COAST-Lab/c3po/Hardware/README.MD

# Bill of Materials
Please note: Prices are listed in USD and are subject to change based on market value and availability.

# Upper Body
Part | Function | Cost | URL
| :---------------- | :------ | :---- | :---- |
Boron LTE-M (NorAm) with EtherSIM (BRN404X) | IoT Development Board with cellular capability | $48.95 | https://store.particle.io/products/boron-lte-cat-m1-noram-with-ethersim-4th-gen
Adalogger FeatherWing - RTC + SD Add-On for All Feather Boards | Real-time I2C clock + SD port; internal datalogging | $8.95 | https://www.adafruit.com/product/2922
CR1220 Coin Battery | Battery for Adalogger FeatherWing | $0.95 |  https://www.adafruit.com/product/380
Samsung EVO Plus 64GB 100/MB/s Micro SDXC Memory Card with Adapter | Store measurements locally | $13.73 | https://www.amazon.com/gp/product/B07349L1WS/ref=sw_img_1?smid=A1VBIOM77ZTQRM&psc=1
Voltaic 5W 5V Solar System | Use solar energy to power sensor electronics | $99.00 |  https://voltaicsystems.com/5-watt-5-volt-35wh-solar-system/
Standard Breadboard | UART to I2C protocol; connecting electronics without soldering (for setup process only) | $2.90 | https://www.digikey.com/en/products/detail/dfrobot/FIT0096/7597069
Jumper cables / prototyping wires | UART to I2C protocol; connecting electronics (for setup process only) | $1.95 | https://www.digikey.com/en/products/detail/adafruit-industries-llc/1954/6827087
Polycase SK-14 | Housing electronics of upper body | $21.77 | https://www.polycase.com/sk-14
CG-32 Cable glands (2), gray, 0.170–0.450in | Threading solar & 4-wire cable into Polycase | $2.86 per; $5.72 total | https://www.polycase.com/cg3-cable-glands#CG-32
3D printed chassis | Holding Boron, Adalogger, & cellular antenna inside Polycase | Custom print | 
Thread-forming mounting boss screws | Fastening 3D printed chassis to Polycase | $8.50 per 100 pack | https://www.polycase.com/screws-022-100

Fastener options for chassis:
Part | Function | Cost | URL
| :---------------- | :------ | :---- | :---- |
18-8 Stainless Steel Socket Head Screw M2.5x0.45mm Thread, 18mm long | Mounting Boron + FeatherWing to chassis | $15.75 per 50 pack | https://www.mcmaster.com/91292A028/
18-8 Stainless Steel Hex Nut M2.5x0.45mm Thread, 2mm height | Mounting Boron & Adalogger to chassis | $6.45 per 100 pack | https://www.mcmaster.com/91828A113/
M2.5x6 or M2.5x5+6mm screws + hex nuts of choice| | | 
M2.5+6.5mm standoffs of choice | | | 

# Lower Body
Part | Function | Cost | URL
| :---------------- | :------ | :---- | :---- |
AtlasScientific K0.1 EZO-Conductivity Kit | Measures water conductivity with range from 0.07µs to 50,000µs | $219.99 | https://atlas-scientific.com/kits/conductivity-k-0-1-kit/
AtlasScientific SMA PT-1000 Temperature Kit | Measures water temperature | $43.99 | https://atlas-scientific.com/kits/sma-temperature-kit/
(N/A) Tentacle T3 Shield | Carrier board for EZO circuits; discontinued | $101.99 | https://www.whiteboxes.ch/docs/tentacle/t3/#/
Altas i3 Interlink | Carrier board for EZO circuits (replaced Tentacle T3 Shield) | $54.99 | https://atlas-scientific.com/electrical-isolation/i3-interlink/
4-wire waterproof cable | Transmit measurements from sensor to EZO board + Boron | $15 ($5/m) | https://bluerobotics.com/store/cables-connectors/pur-subsea-cable/
Female 3.5x1.1mm - MicroUSB Adapter | Connects solar panel to Boron | $3.00 | https://voltaicsystems.com/A101
3" Sch 40 PVC pipe | Encloses sensors; attaches to signpost | $10.96 ($5.98/ft, sold as 24in) | https://www.homedepot.com/p/IPEX-3-in-x-24-in-Rigid-PVC-Schedule-40-Pipe-2203/205706641
3D printed pipe cap, top | Pipe cap, with attached chassis to hold i3 Interlink with EZO circuits inside PVC pipe | Custom print | 
Cable gland (1), 0.105–0.315in | Waterproof cable entry for 4-wire cable | $2.23/unit | https://www.polycase.com/cg3-cable-glands#CG-31
3D printed pipe cap, bottom | For bottom of PVC pipe, where probes are fastened & exit pipe | Custom print |
Loctite Marine Epoxy | Attaching pipe caps to PVC pipe; attaching propes to pipe caps; waterproof sealant | $7.20 | https://www.amazon.com/dp/B00KH62K50?tag=psuni-01-us-340-20&ascsubtag=wtbs_6792893518cb9545d7275495&th=1

Fastener options for chassis:
Part | Function | Cost | URL
| :---------------- | :------ | :---- | :---- |
18-8 Stainless Steel Socket Head Screw M2.5x0.45mm Thread, 10mm long | Mounting i3 Interlink to chassis | $6.54 per 100 pack | https://www.mcmaster.com/91292A014/
18-8 Stainless Steel Hex Nut M2.5x0.45mm Thread, 2mm height | Mounting i3 Interlink to chassis | $6.45 per 100 pack | https://www.mcmaster.com/91828A113/
M2.5x0.45mm screws + hex nuts of choice | | |
M2.5x0.45mm standoffs of choice | | |
