COAST-Lab/c3po/Removable_Housing/ReadMe.md

Objectives:
- Create an upgraded housing that allows easy access to electrical components and sensors
  while maintaining water tight reliability
- Add opening for pressure transducer

Design Improvements:

 **Removable End Caps** 
  - Sensor cap (facing downwards)
  - Top cap (port to brain/power)
  This allows for easy access to internal components without damaging the housing.

 **Exterior Fastening**
- Each cap was designed with a circular overhang with 2 (oppisite side) 1/4 inch holes
- Each hole is used for a 1/4 inch screw to lock-in endcaps
- Screws are fastened on oppisite sides with hex nuts

 **O-Ring Sealing System**  
- The housing uses O-ring grooves to maintain a watertight seal while still allowing repeated
  opening and closing.

 **Pressure Sensor Integration**  
- An additional port has been incorporated to accommodate a pressure sensor, enabling depth
  measurements to be included in the system’s output data.

**Benefits**
- Non-destructive access to electronics and sensors  
- Improved maintenance and replacement capability  (for sensors, interlink, etc..)
- Reusable housing design  
- Expanded data collection through depth sensing

**Notes**
- This design is intended for testing. Fit, sealing performance, and materials 
(sanding requirments and O-ring compression) should be validated before field use.
