COAST-Lab/c3po/Data Analysis/Figures/c3po_time-series_2025-Apr-Oct.png

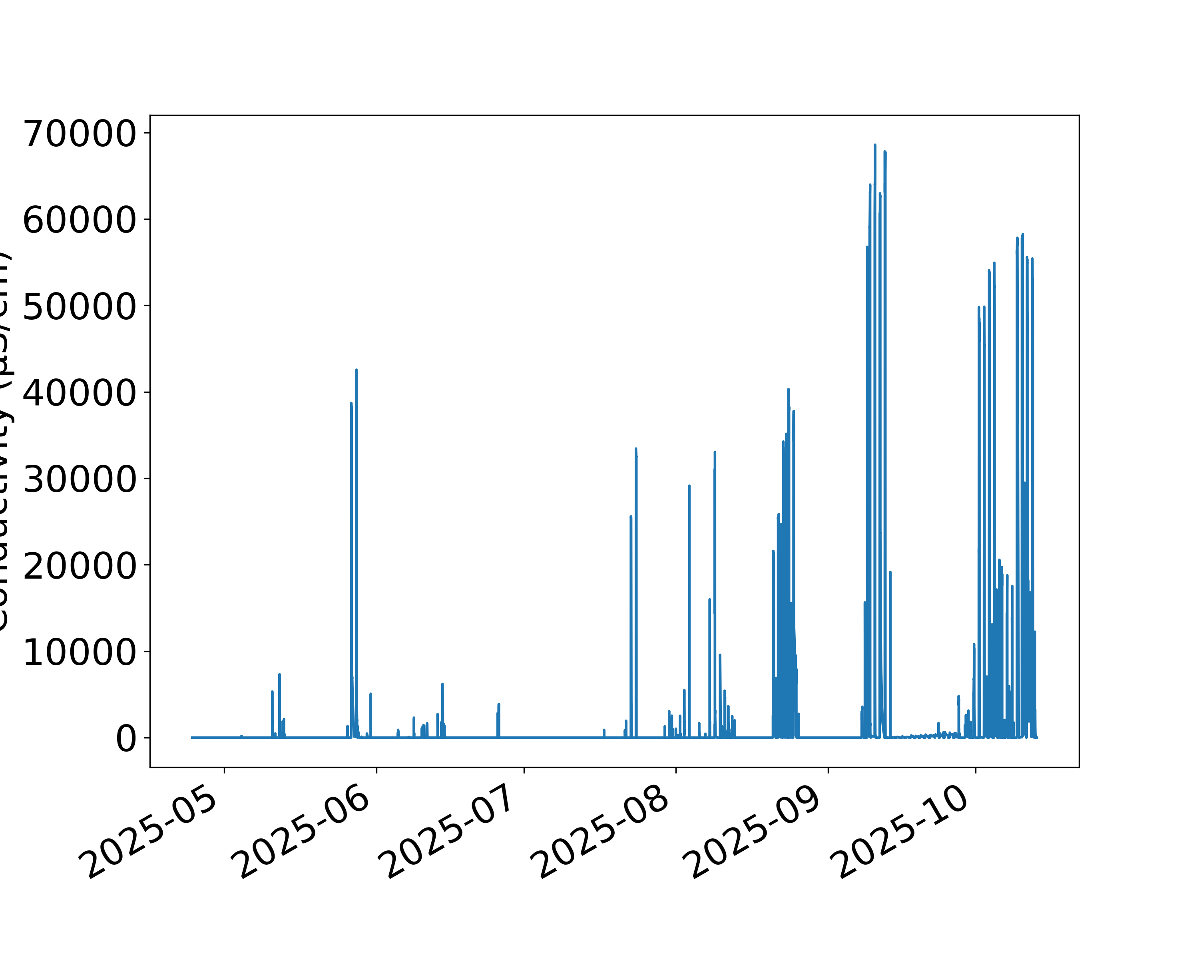
Data Analysis/Figures/c3po_time-series_2025-Apr-Oct.png
