COAST-Lab/c3po/Data Analysis/Figures/C3PO_waterlevel_example.png

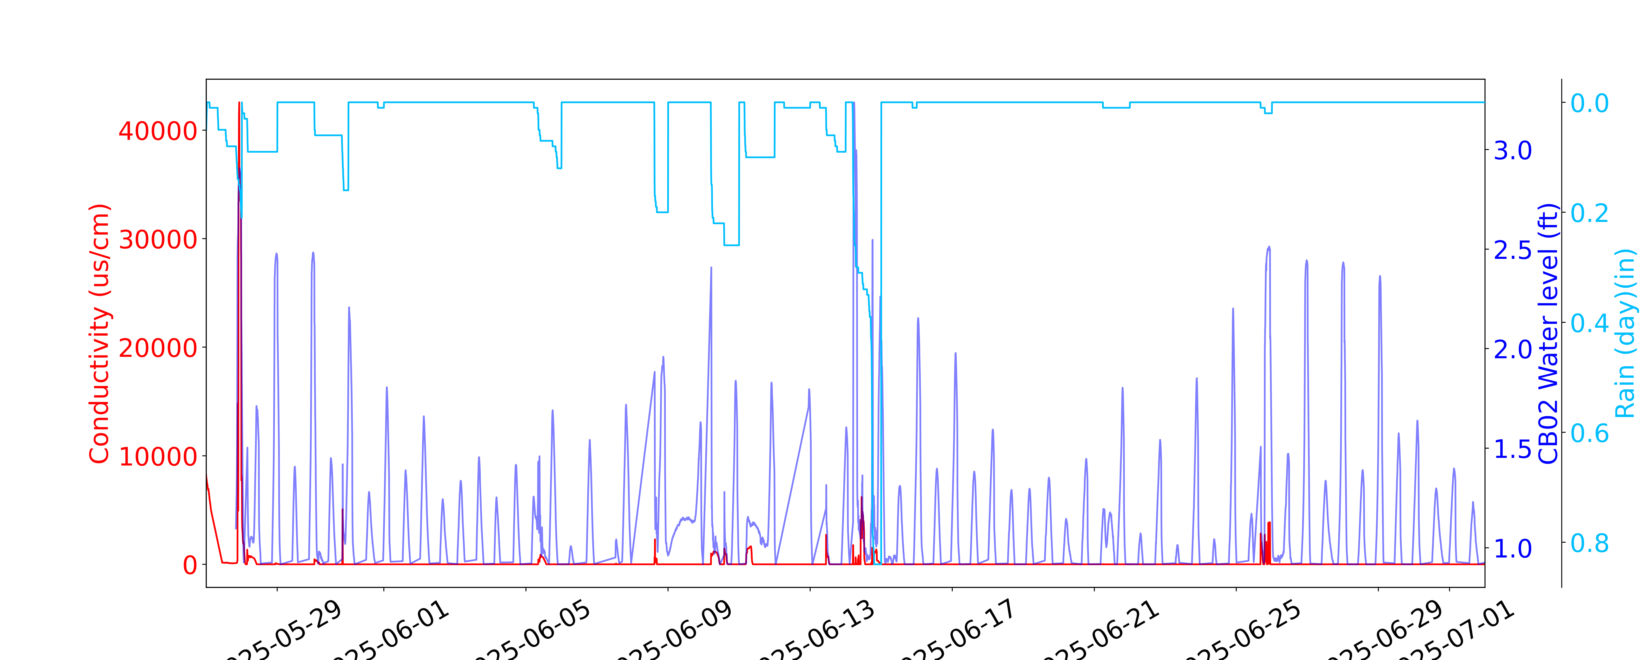
Data Analysis/Figures/C3PO_waterlevel_example.png
