COAST-Lab/c3po/Data Analysis/Figures/C3PO_waterlevel_salinity_lf.png

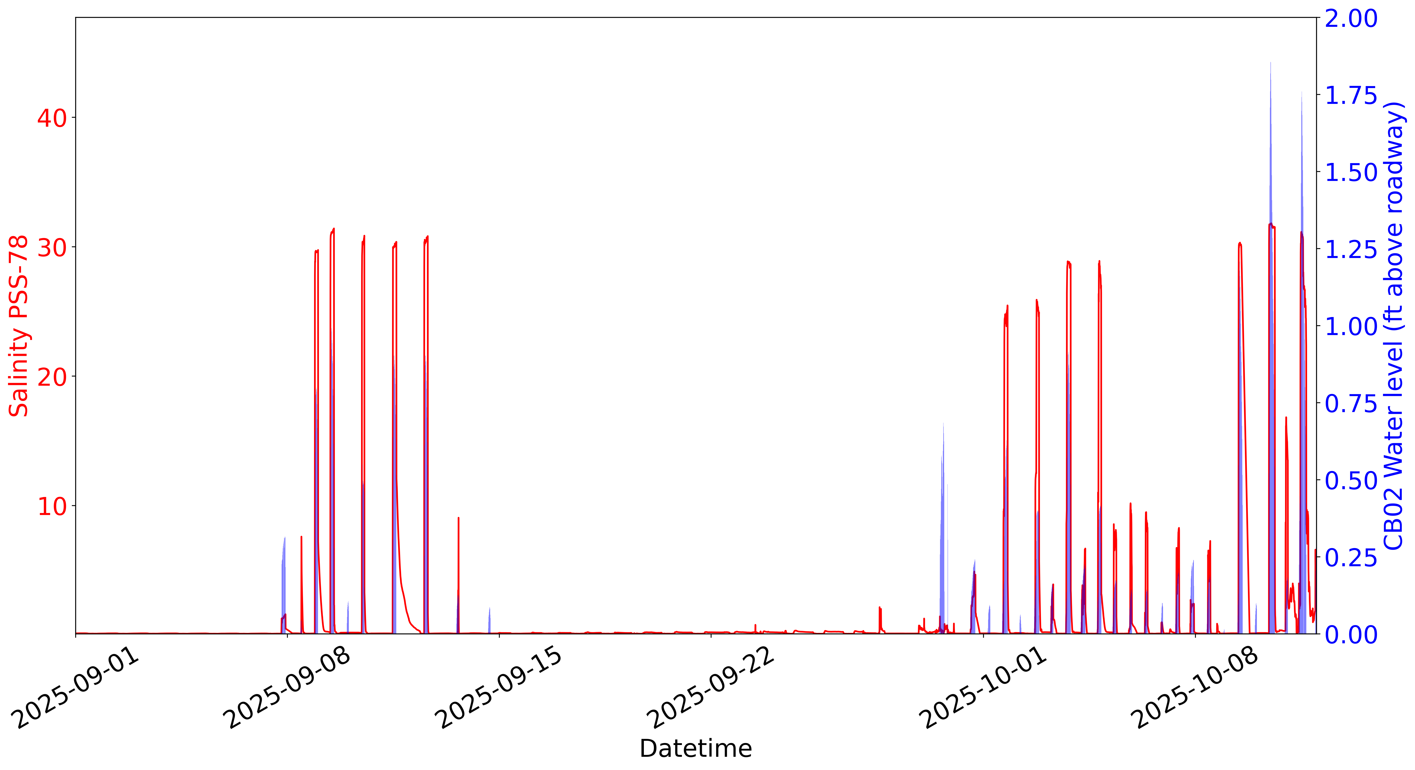
Data Analysis/Figures/C3PO_waterlevel_salinity_lf.png
