COAST-Lab/c3po/Data Analysis/Figures/C3PO_waterlevel_salinity_pjb.png

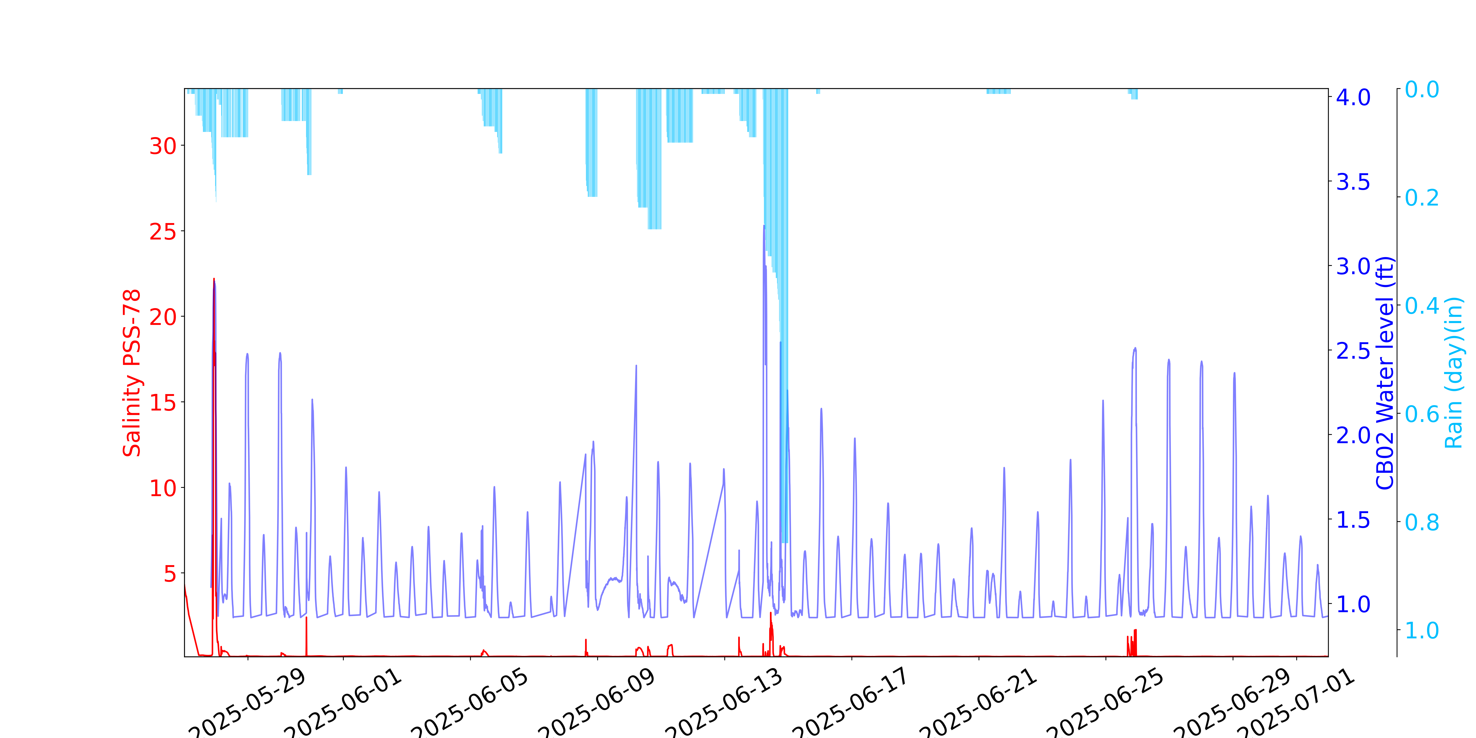
Data Analysis/Figures/C3PO_waterlevel_salinity_pjb.png
