COAST-Lab/c3po/Data Analysis/Figures/C3POExample.png

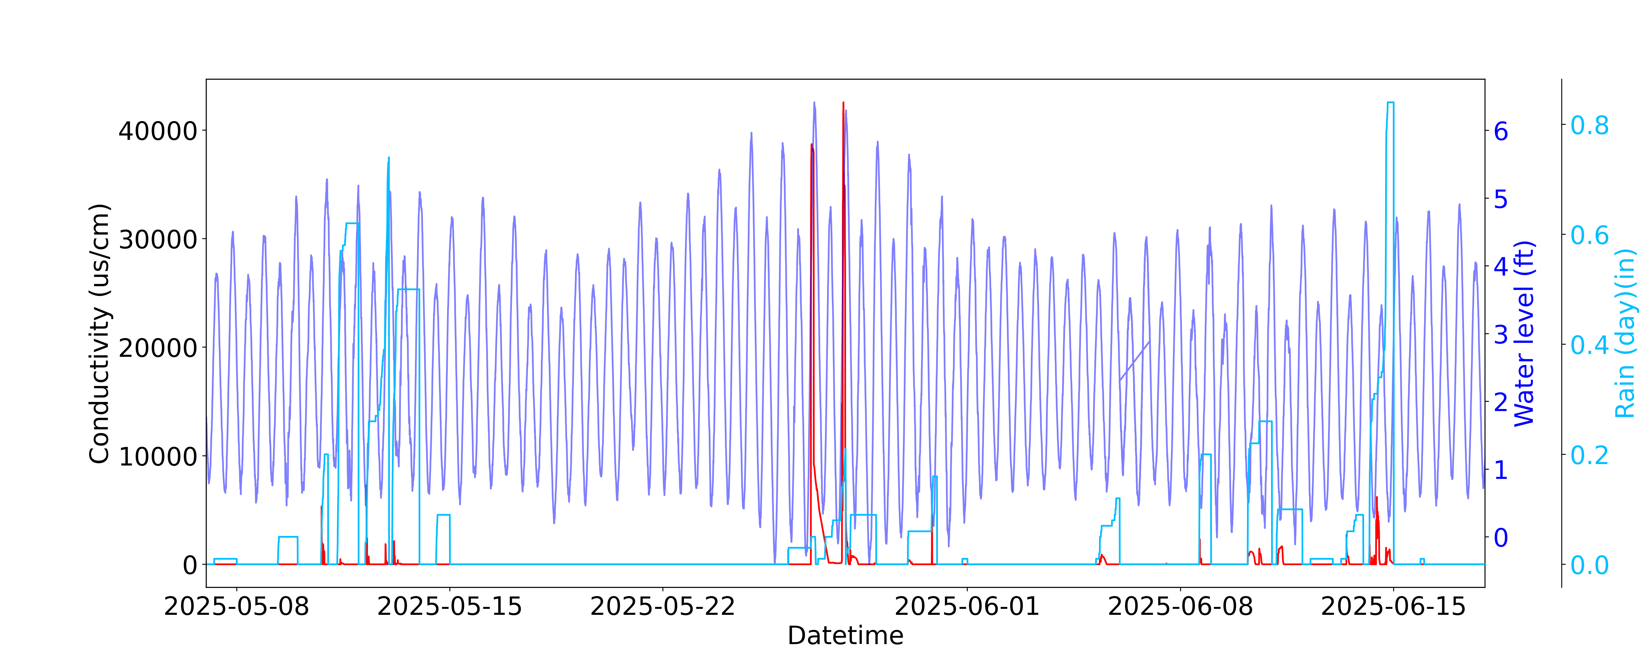
Data Analysis/Figures/C3POExample.png
