COAST-Lab/c3po/Documentation/Photos/Atlas_CarrierBoard.jpeg

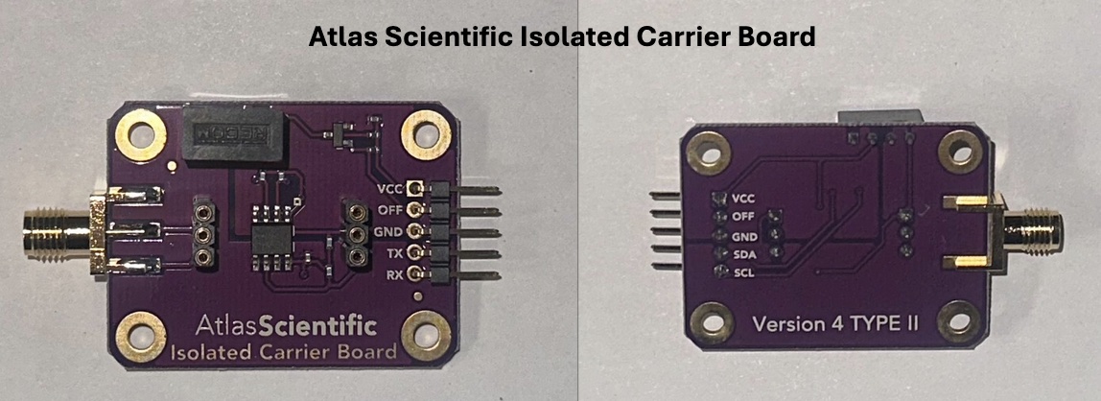
Documentation/Photos/Atlas_CarrierBoard.jpeg
