COAST-Lab/c3po/Documentation/Photos/AtlasSci_EC_EZO.jpeg

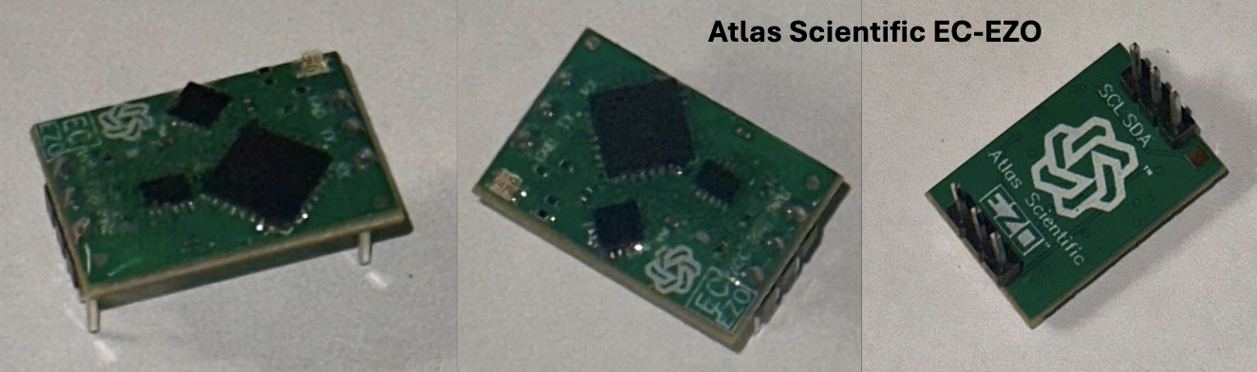
Documentation/Photos/AtlasSci_EC_EZO.jpeg
