COAST-Lab/c3po/Photos/Probes.jpg

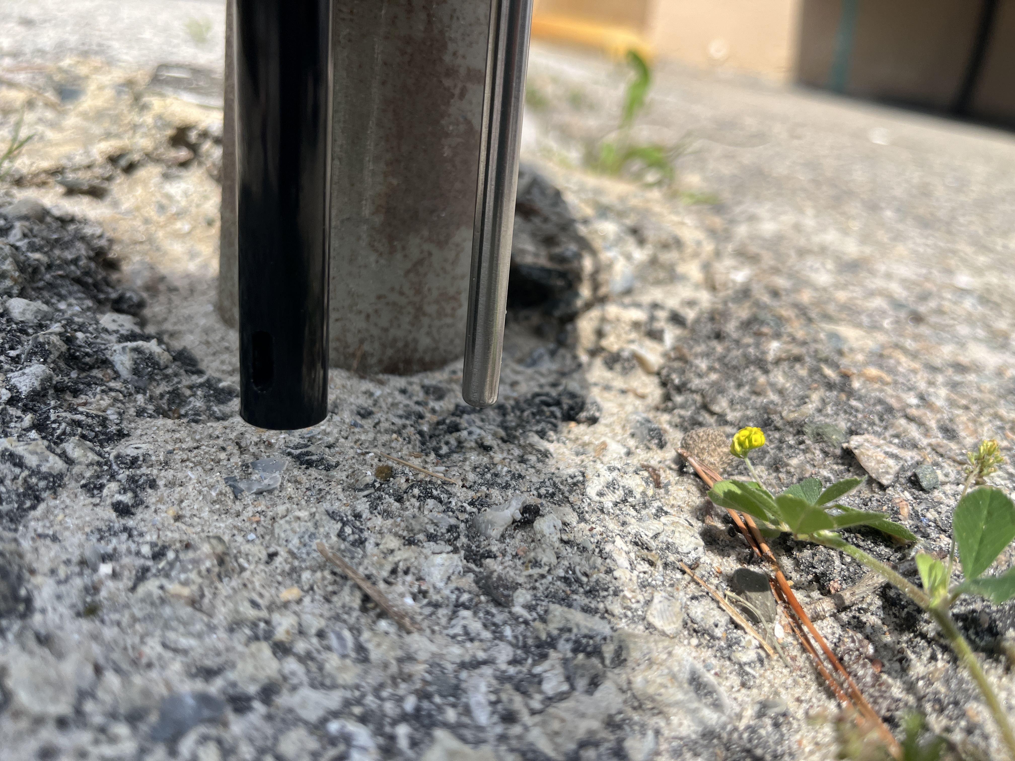
Photos/Probes.jpg
