COAST-Lab/c3po/Photos/StarfishLn.jpg

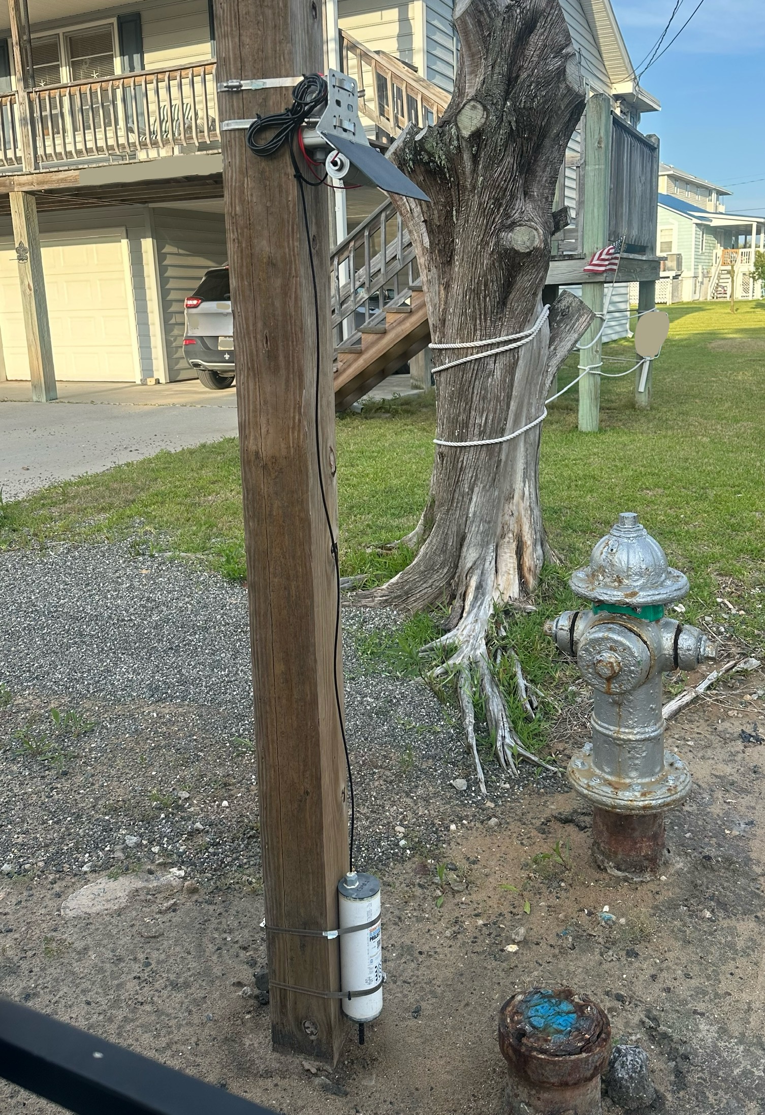
Photos/StarfishLn.jpg
