COAST-Lab/c3po/Photos/UpperBody2.JPG

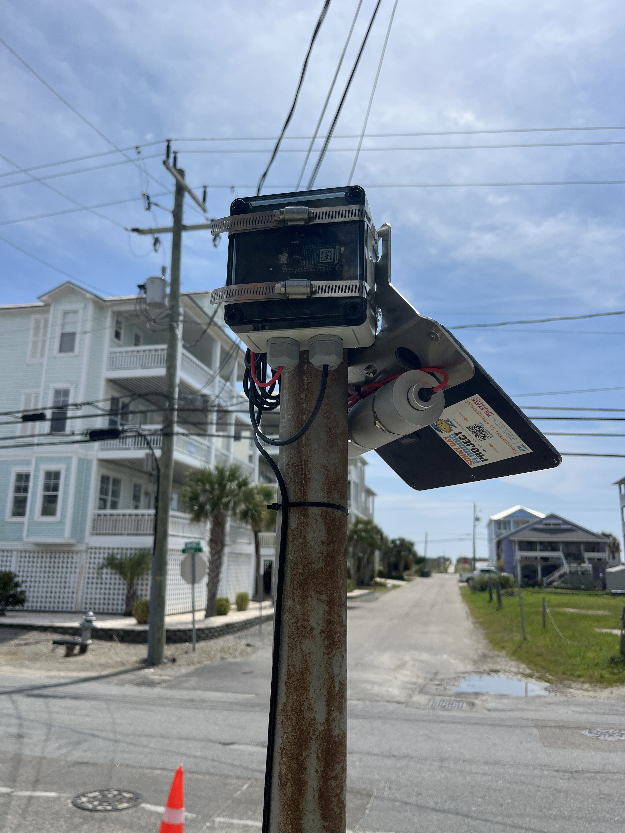
Photos/UpperBody2.JPG
