COAST-Lab/c3po/Removable_Housing/C3PO_Concept.png

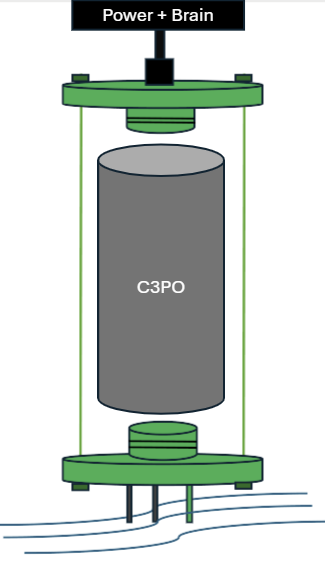
Removable_Housing/C3PO_Concept.png
