COAST-Lab/c3po/Hardware/solar_panel_mount_v4.stl

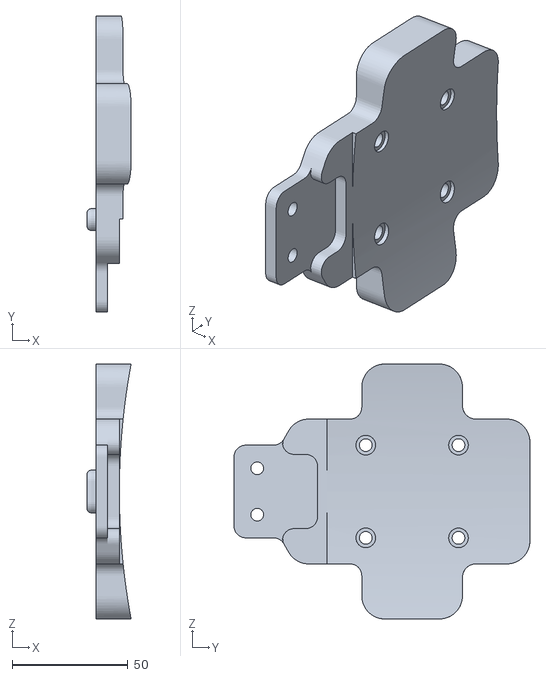
[picture p20: CAD file, 2025-06-25]
Hardware/solar_panel_mount_v4.stl
19.1 x 127.7 x 110.0
