COAST-Lab/c3po/Hardware/C3POPolycaseMountpart.stl

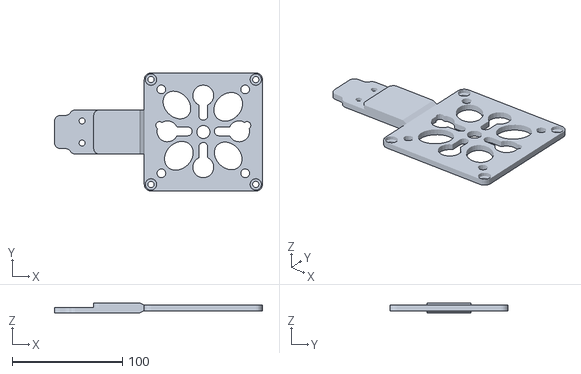
[picture p22: CAD file, 2025-06-25]
Hardware/C3POPolycaseMountpart.stl
188.5 x 107.2 x 9.00
