COAST-Lab/c3po/Removable_Housing/C3PO_TopCap_CableHole.stl

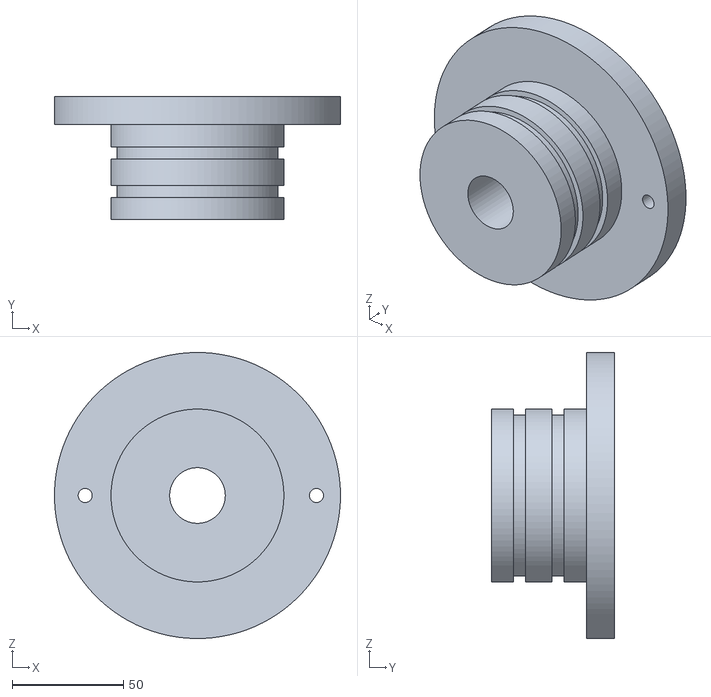
[picture p23: CAD file, 2026-04-23]
Removable_Housing/C3PO_TopCap_CableHole.stl
128.4 x 55.3 x 128.4
