COAST-Lab/c3po/Hardware/BottomCap_NoGrooves_20250508.stl

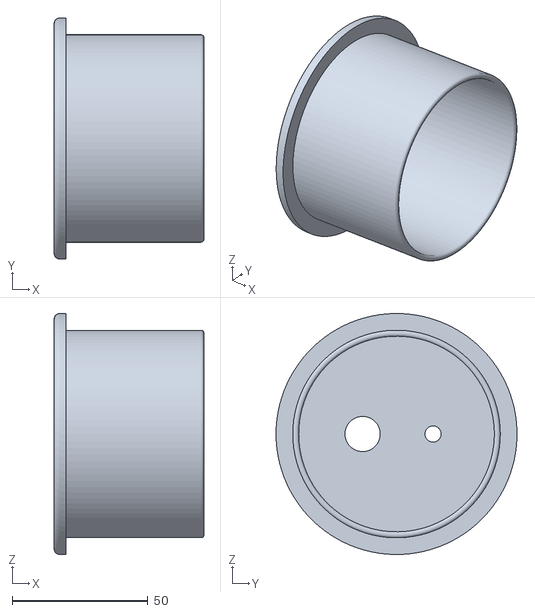
[picture p24: CAD file, 2025-05-08]
Hardware/BottomCap_NoGrooves_20250508.stl
55.2 x 88.9 x 88.9
