COAST-Lab/c3po/Removable_Housing/C3PO_RobustCap_04132026.stl

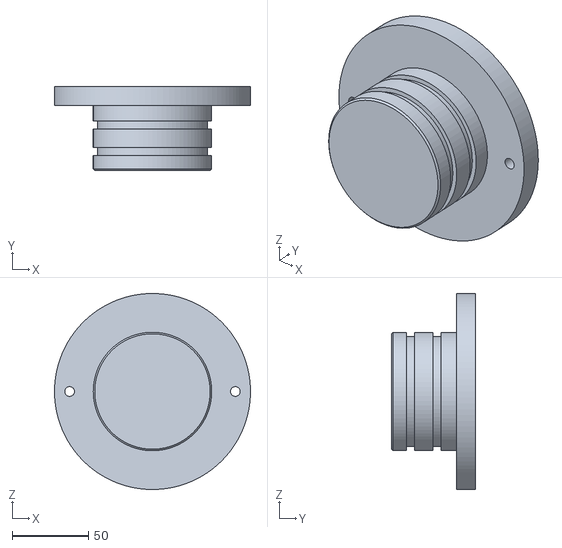
[picture p25: CAD file, 2026-04-20]
Removable_Housing/C3PO_RobustCap_04132026.stl
128.4 x 55.3 x 128.4
