COAST-Lab/c3po/Hardware/TopCap_NoGrooves_20250508.stl

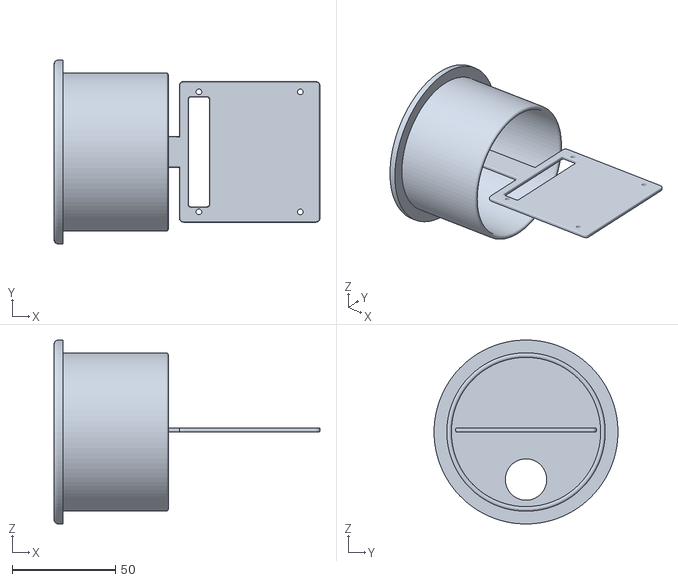
[picture p26: CAD file, 2025-05-08]
Hardware/TopCap_NoGrooves_20250508.stl
128.5 x 88.9 x 88.9
