COAST-Lab/c3po/Hardware/UpperChassis_20250408.stl

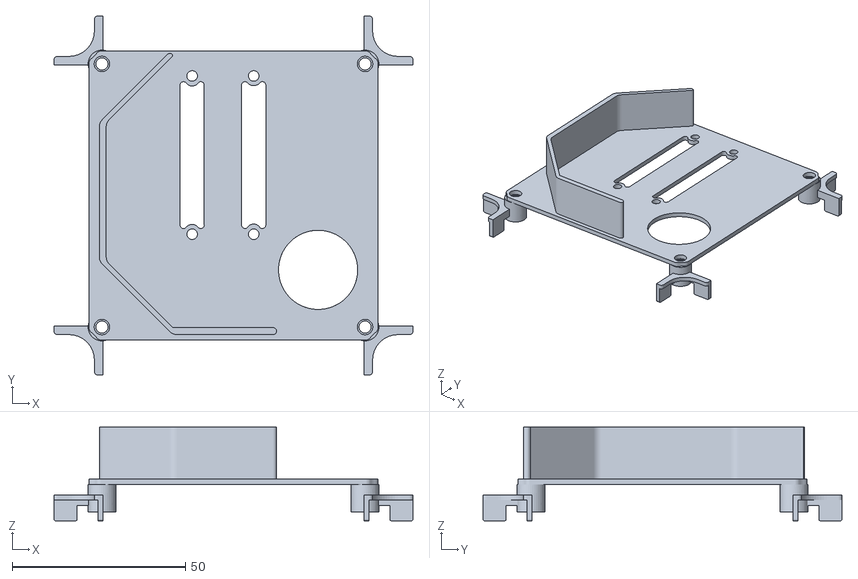
[picture p27: CAD file, 2025-04-09]
Hardware/UpperChassis_20250408.stl
103.7 x 103.7 x 27.1
