COAST-Lab/c3po/Hardware/TopCap_20250408.stl

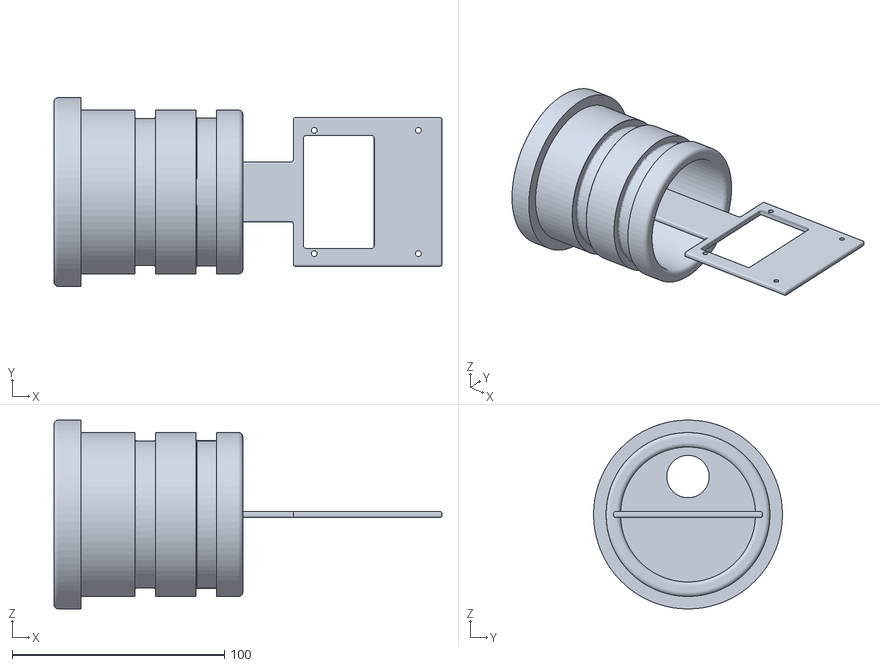
[picture p28: CAD file, 2025-04-03]
Hardware/TopCap_20250408.stl
182.6 x 88.9 x 88.9
