COAST-Lab/c3po/Hardware/BottomCap_20250408.stl

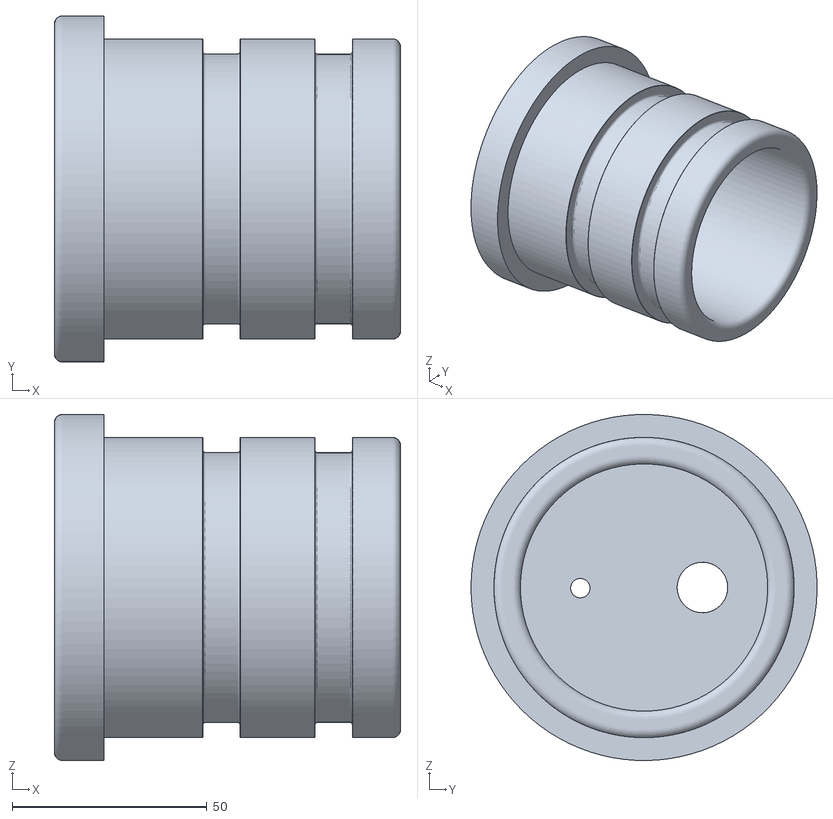
[picture p29: CAD file, 2025-04-03]
Hardware/BottomCap_20250408.stl
88.9 x 88.9 x 88.9
