COAST-Lab/c3po/(list of files, cad)

Other CAD files:
Hardware/UpperBody_Chassis_20250328.stl
Hardware/Old/UpperBody_Chassis_20250328.stl
Removable_Housing/Robust_Cap_NoHoles.f3d
Removable_Housing/Robust_Cap_ScrewHoles.f3d
