COAST-Lab/c3po/Calibrations/C3PO_2/2025_12_22_Calibration/step_pts.txt

cond_uscm,datetime
0,2025-12-22 10:59:04
0,2025-12-22 11:04:57
12880,2025-12-22 11:05:56
12880,2025-12-22 11:11:41
80000,2025-12-22 11:12:47
80000,2025-12-22 11:18:20
