COAST-Lab/c3po/Calibrations/C3PO_3/2025_12_22_Calibration/step_pts.txt

cond_uscm,datetime
0,2025-12-22 11:22:58
0,2025-12-22 11:28:34
12880,2025-12-22 11:29:12
12880,2025-12-22 11:34:51
80000,2025-12-22 11:35:34
80000,2025-12-22 11:41:34
