COAST-Lab/c3po/Calibrations/C3PO_4/2025_12_22_Calibration/step_pts.txt

cond_uscm,datetime
0,2025-12-22 11:45:14
0,2025-12-22 11:50:49
12880,2025-12-22 11:51:29
12880,2025-12-22 11:57:03
80000,2025-12-22 11:57:49
80000,2025-12-22 12:03:49
