COAST-Lab/c3po/Calibrations/C3PO_5/2025_12_22_Calibration/step_pts.txt

cond_uscm,datetime
0,2025-12-22 12:06:45
0,2025-12-22 12:12:17
12880,2025-12-22 12:12:41
12880,2025-12-22 12:18:15
80000,2025-12-22 12:18:54
80000,2025-12-22 12:24:26
