COAST-Lab/c3po/Calibrations/C3PO_2/2026_07_22_ReCalibration/step_pts.txt

cond_uscm,datetime
0,2026-7-22 15:29:15
0,2026-7-22 15:34:47
12880,2026-7-22 15:35:30
12880,2026-7-22 15:40:47
80000,2026-7-22 15:41:55
80000,2026-7-22 15:49:30
