COAST-Lab/c3po/Calibrations/C3PO_3/2026_07_22_ReCalibration/step_pts.txt

cond_uscm,datetime
0,2026-7-22 15:00:45
0,2026-7-22 15:06:00
12880,2026-7-22 15:06:45
12880,2026-7-22 15:14:00
80000,2026-7-22 15:18:20
80000,2026-7-22 15:24:00
