COAST-Lab/c3po/Calibrations/C3PO_4/2026_07_22_ReCalibration/step_pts.txt

cond_uscm,datetime
0,2026-7-22 14:37:00
0,2026-7-22 14:42:15
12880,2026-7-22 14:43:00
12880,2026-7-22 14:48:15
80000,2026-7-22 14:49:30
80000,2026-7-22 14:54:40
