COAST-Lab/c3po/Calibrations/C3PO_5/2026_07_22_ReCalibration/step_pts.txt

cond_uscm,datetime
0,2026-7-22 14:10:25
0,2026-7-22 14:15:45
12880,2026-7-22 14:16:45
12880,2026-7-22 14:21:45
80000,2026-7-22 14:23:21
80000,2026-7-22 14:28:45
