COAST-Lab/c3po/Calibrations/C3PO_6/2026_07_22_Calibration/step_pts.txt

cond_uscm,datetime
0,2026-7-22 13:43:30
0,2026-7-22 13:49:00
12880,2026-7-22 13:50:25
12880,2026-7-22 13:58:00
80000,2026-7-22 13:59:28
80000,2026-7-22 14:05:00
