COAST-Lab/c3po/Calibrations/C3PO_1/2025_04_23_Calibration/step_pts.txt

cond_uscm,datetime
0,2025-04-23 12:34:40
0,2025-04-23 12:41:52
12880,2025-04-23 12:41:53
12880,2025-04-23 12:51:30
80000,2025-04-23 12:51:31
80000,2025-04-23 12:59:40
