COAST-Lab/c3po/Documentation/Photos/WiringDiagram_20241101.jpg

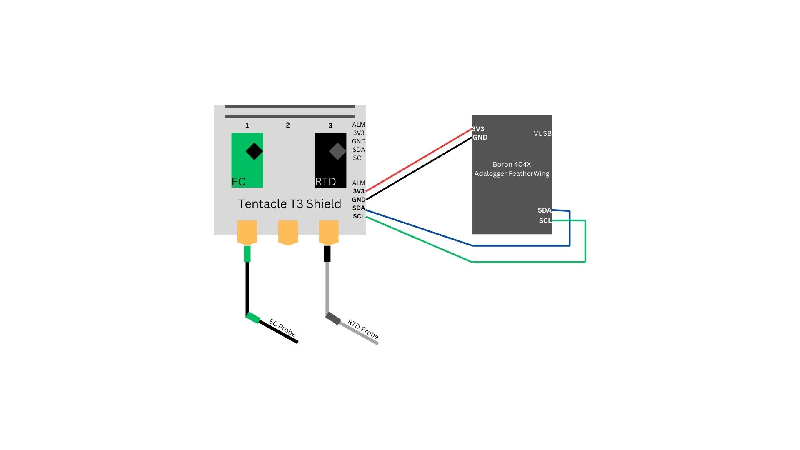
Documentation/Photos/WiringDiagram_20241101.jpg
