COAST-Lab/c3po/Wiring Diagram/ConductivitySensorDiagram.png

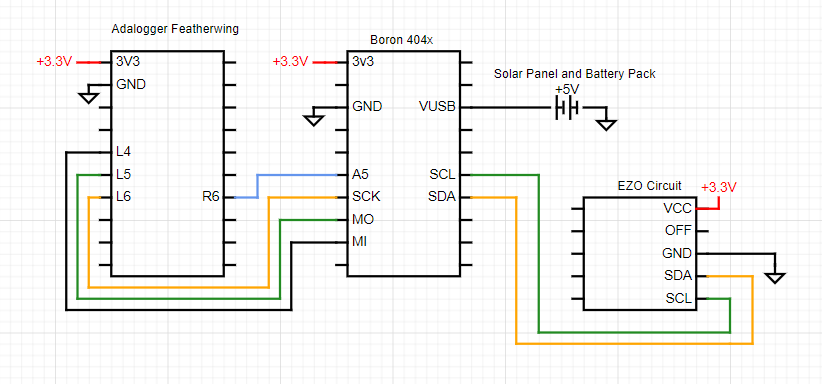
Wiring Diagram/ConductivitySensorDiagram.png
