COAST-Lab/c3po/Calibrations/Intercomparison Experiment/README_IntercomparisonExperiment.md

This file describes an intercomparison experiment that was conducted between the different C3POs and a EX02 YSI across different 
temperatures and salinities. It is recorded here for future consistency. 

Materials Needed
- Cooler
- C3POs with charged batteries and sampling rate set to 20 seconds 
- EXO2 YSI 
- Heat exchanger and water bath 
- Submersible pump

Step 1.

Rinse out the cooler to ensure there is not previous residue inside, as well as the heat exchanger. 

Set up the C3POs so they are inside the cooler, ensuring that their probes are not touching the bottom of the cooler but will 
be submerged once water is added. 

[insert pic]

Step 2. 

Fill the cooler up with just enough deionized water so that the YSI, the heat exchanger, and the C3PO probes are all submerged. 
Add the submersible pump into the cooler to ensure even mixing. 

Turn on the water bath and set the temperature to 10 degrees C. It takes awhile for the water to get down to 10C, so you may want to let it run overnight. 

Step 3. 

Once the cooler has come to temperature, turn on the C3POs by plugging in their battery and 
ensure to record the exact time they were plugged into power. 

Hit "start recording" on the YSI at a sampling rate of 10 seconds and use the temperature from the YSI probe to assess if the water 
bath temperature is where it should be. 

Step 4. 

Once the temperature has stabilized at 10 degrees C, let the sensors record for at least 30 minutes. Then, increase the temperature to 
30 degrees C, wait for water temp to stabilize, and let sensors record for another at least 30 minutes past that. 

Step 5. 

After 30+ minutes of data collection at 30 degrees C, add 17 L of saltwater to the system (or however much it takes to make brackish water). Wait until the temperature has restabilized , and then decrease the temperature back down to 10 degrees C. Again, it takes much longer for the water to cool than it does to heat up, so this may run for quite awhile. 

Step 6. 

Offload the data from the instruments and plot using [insert link to code
