COAST-Lab/c3po/Calibrations/C3PO_2/2025_12_22_Calibration/Notes.txt

conducted 12/22/2025 by Liz Farquhar 
C3PO2 powered on at 10:55:06 am
