COAST-Lab/c3po/Calibrations/C3PO_3/2025_12_22_Calibration/Notes.txt

conducted 12/22/2025 by Liz Farquhar
C3PO3 powered on at 11:21:46 am
