COAST-Lab/c3po/Calibrations/C3PO_3/2026_07_22_ReCalibration/Notes.txt

conducted 7/22/2026 by Liz Farquhar
C3PO3 powered on at 14:59:32 

Got confused and accidentally restarted it at 3:18:17 pm while sitting in the 80,000. I fixed the final csv file before processing
