COAST-Lab/c3po/Calibrations/C3PO_4/2025_12_22_Calibration/Notes.txt

conducted 12/22/2025 by Liz Farquhar 
C3PO4 powered on at 11:44:43 am
