COAST-Lab/c3po/Calibrations/C3PO_5/2025_12_22_Calibration/Notes.txt

conducted 12/22/2025 by Liz Farquhar
C3PO5 powered on at 12:06:08
