COAST-Lab/c3po/Calibrations/C3PO_2/2026_07_22_ReCalibration/Notes.txt

conducted 7/22/2026 by Liz Farquhar 
C3PO2 powered on at 15:28:21
