COAST-Lab/c3po/Calibrations/C3PO_4/2026_07_22_ReCalibration/Notes.txt

conducted 7/22/2026 by Liz Farquhar 
C3PO4 powered on at 14:33:49 

There was something crusty in the probe; could be why it was reading weird before
