COAST-Lab/c3po/Calibrations/C3PO_5/2026_07_22_ReCalibration/Notes.txt

conducted 7/22/2026 by Liz Farquhar
C3PO5 powered on at 14:09:16
