COAST-Lab/c3po/Calibrations/Intercomparison Experiment/Kor Measurement File Export - 073026 134433_C3POIntercomparisonExperiment.csv

Kor MEASUREMENT DATA FILE EXPORT
FILE CREATED: | 7/30/2026 5:45:08 PM
MEAN VALUE: |  |  |  |  | -0.35 | 755.1 | 0.02 | 15184.9 | 19737.1 | 12829 | 11.86 | 20030.9 | 0.111 | 0.111 | 0.159 | 96.5 | 9.39 | 97.1 | 7.84 | 1.75 | 0.00000 | 0.00000 | 0.0 | NA | -51.8 | 12.0 | 0.00 | 13.807 | 0.38 | 0
STANDARD DEVIATION: |  |  |  |  | 0.07 | 1.6 | 0.02 | 5182.2 | 6201.0 | 4031 | 3.73 | 6295.8 | 0.032 | 0.032 | 0.046 | 5.4 | 1.03 | 5.4 | 2.39 | 0.73 | 0.00000 | 0.00000 | 0.0 | 0.42 | 24.1 | 0.0 | 0.00 | 6.105 | 0.07 | 0
SENSOR SERIAL NUMBER: |  |  |  |  | 23A100996 | 23A105694 | 23A100996 | 23E102415 | 23E102415 | 23E102415 | 23E102415 | 23E102415 | 22M102817 | 22M102817 | 22M102817 | 22M103265 | 22M103265 | 22M103265 | 23B100876 | 23B100876 | 23A105694 | 23A105694 | 23A105694 | 23B102284 | 23B102284 | 23A105694 | 23A105694 | 23E102415 | 23B100558 | 23B100558
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
