COAST-Lab/c3po/Calibrations/C3PO_1/2025_04_23_Calibration/merged.csv

cond_uscm | datetime | Real_Time | Temp_C | Cond_uScm-1 | Elapsed_sec
0 | 2025-04-23 12:34:40 | 946684942 | 21.95 | 0 | 137
0 | 2025-04-23 12:35:00 | 946684962 | 23.34 | 0 | 157
0 | 2025-04-23 12:35:20 | 946684982 | 23.65 | 0 | 177
0 | 2025-04-23 12:35:40 | 946685002 | 23.66 | 0 | 197
0 | 2025-04-23 12:36:00 | 946685022 | 23.67 | 0 | 217
0 | 2025-04-23 12:36:20 | 946685042 | 23.67 | 0 | 237
0 | 2025-04-23 12:36:40 | 946685062 | 23.67 | 0 | 257
0 | 2025-04-23 12:37:00 | 946685082 | 23.66 | 0 | 277
0 | 2025-04-23 12:37:20 | 946685102 | 23.65 | 0 | 297
0 | 2025-04-23 12:37:40 | 946685122 | 23.63 | 0 | 317
0 | 2025-04-23 12:38:00 | 946685142 | 23.61 | 0 | 337
0 | 2025-04-23 12:38:20 | 946685162 | 23.59 | 0 | 357
0 | 2025-04-23 12:38:40 | 946685182 | 23.57 | 0 | 377
0 | 2025-04-23 12:39:00 | 946685202 | 23.55 | 0 | 397
0 | 2025-04-23 12:39:20 | 946685222 | 23.52 | 0 | 417
0 | 2025-04-23 12:39:40 | 946685242 | 23.5 | 0 | 437
0 | 2025-04-23 12:40:00 | 946685263 | 23.48 | 0 | 458
0 | 2025-04-23 12:40:20 | 946685283 | 23.45 | 0 | 478
0 | 2025-04-23 12:40:40 | 946685303 | 23.43 | 0 | 498
0 | 2025-04-23 12:41:00 | 946685323 | 23.02 | 0 | 518
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
