COAST-Lab/c3po/Calibrations/C3PO_2/2026_07_22_ReCalibration/merged.csv

cond_uscm | datetime | Real_Time | Temp_C | Cond_uScm-1 | CellVoltage | StateofCharge | ErrorCode | Elapsed_sec | Cond_uScm-1_cal
0 | 2026-07-22 15:29:15 | 946684863 | 23.15 | 0 | 0.04 | 93.86 | 0 | 58 | -51.14
0 | 2026-07-22 15:29:35 | 946684882 | 23.32 | 0 | 0.04 | 92.44 | 0 | 77 | -51.14
0 | 2026-07-22 15:29:55 | 946684902 | 23.36 | 0 | 0.04 | 91.02 | 0 | 97 | -51.14
0 | 2026-07-22 15:30:15 | 946684922 | 23.33 | 0 | 0.04 | 89.43 | 0 | 117 | -51.14
0 | 2026-07-22 15:30:35 | 946684943 | 23.19 | 0 | 0.04 | 87.93 | 0 | 138 | -51.14
0 | 2026-07-22 15:30:55 | 946684963 | 23.34 | 0 | 0.04 | 86.34 | 0 | 158 | -51.14
0 | 2026-07-22 15:31:15 | 946684982 | 23.35 | 0 | 0.04 | 84.91 | 0 | 177 | -51.14
0 | 2026-07-22 15:31:35 | 946685002 | 23.34 | 0 | 0.04 | 83.36 | 0 | 197 | -51.14
0 | 2026-07-22 15:31:55 | 946685022 | 23.33 | 0 | 0.04 | 81.89 | 0 | 217 | -51.14
0 | 2026-07-22 15:32:15 | 946685043 | 23.32 | 0 | 0.04 | 80.42 | 0 | 238 | -51.14
0 | 2026-07-22 15:32:35 | 946685063 | 23.38 | 0 | 0.04 | 78.95 | 0 | 258 | -51.14
0 | 2026-07-22 15:32:55 | 946685082 | 23.38 | 0 | 0.04 | 77.48 | 0 | 277 | -51.14
0 | 2026-07-22 15:33:15 | 946685102 | 23.46 | 0 | 0.04 | 75.86 | 0 | 297 | -51.14
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
