COAST-Lab/c3po/Calibrations/C3PO_5/2025_12_22_Calibration/merged.csv

cond_uscm | datetime | Real_Time | Temp_C | Cond_uScm-1 | CellVoltage | StateofCharge | ErrorCode | Elapsed_sec | Cond_uScm-1_cal
0 | 2025-12-22 12:06:45 | 946684843 | 20.57 | 0 | 3.94 | 56 | 0 | 37 | -189.8
0 | 2025-12-22 12:07:05 | 946684862 | 21.13 | 0 | 3.95 | 56 | 0 | 56 | -189.8
0 | 2025-12-22 12:07:25 | 946684882 | 21.25 | 0 | 3.95 | 56 | 0 | 76 | -189.8
0 | 2025-12-22 12:07:45 | 946684903 | 21.26 | 0 | 3.95 | 56 | 0 | 97 | -189.8
0 | 2025-12-22 12:08:05 | 946684923 | 21.26 | 0 | 3.95 | 56 | 0 | 117 | -189.8
0 | 2025-12-22 12:08:25 | 946684943 | 21.27 | 0 | 3.95 | 56 | 0 | 137 | -189.8
0 | 2025-12-22 12:08:45 | 946684962 | 21.27 | 0 | 3.95 | 56 | 0 | 156 | -189.8
0 | 2025-12-22 12:09:05 | 946684982 | 21.19 | 0 | 3.96 | 56.31 | 0 | 176 | -189.8
0 | 2025-12-22 12:09:25 | 946685002 | 21.34 | 0 | 3.96 | 56.31 | 0 | 196 | -189.8
0 | 2025-12-22 12:09:45 | 946685023 | 21.11 | 0 | 3.96 | 56.31 | 0 | 217 | -189.8
0 | 2025-12-22 12:10:05 | 946685043 | 21.43 | 0 | 3.96 | 56.31 | 0 | 237 | -189.8
0 | 2025-12-22 12:10:25 | 946685062 | 21.22 | 0 | 3.96 | 56.31 | 0 | 256 | -189.8
0 | 2025-12-22 12:10:45 | 946685082 | 21.18 | 0 | 3.96 | 56.31 | 0 | 276 | -189.8
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
