COAST-Lab/c3po/Calibrations/C3PO_6/2026_07_22_Calibration/merged.csv

cond_uscm | datetime | Real_Time | Temp_C | Cond_uScm-1 | CellVoltage | StateofCharge | ErrorCode | Elapsed_sec | Cond_uScm-1_cal
0 | 2026-07-22 13:43:30 | 946685302 | 22.65 | 0 | 0.05 | 62.53 | 0 | 497 | -189.8
0 | 2026-07-22 13:43:50 | 946685323 | 23.06 | 0 | 0.05 | 61.06 | 0 | 518 | -189.8
0 | 2026-07-22 13:44:10 | 946685343 | 23.08 | 0 | 0.05 | 59.79 | 0 | 538 | -189.8
0 | 2026-07-22 13:44:30 | 946685363 | 23.1 | 0 | 0.05 | 58.53 | 0 | 558 | -189.8
0 | 2026-07-22 13:44:50 | 946685382 | 23.13 | 0 | 0.05 | 56.95 | 0 | 577 | -189.8
0 | 2026-07-22 13:45:10 | 946685402 | 23.15 | 0 | 0.05 | 55.36 | 0 | 597 | -189.8
0 | 2026-07-22 13:45:30 | 946685423 | 23.17 | 0 | 0.05 | 54.1 | 0 | 618 | -189.8
0 | 2026-07-22 13:45:50 | 946685443 | 23.18 | 0 | 0.05 | 52.7 | 0 | 638 | -189.8
0 | 2026-07-22 13:46:10 | 946685463 | 23.19 | 0 | 0.05 | 51.16 | 0 | 658 | -189.8
0 | 2026-07-22 13:46:30 | 946685482 | 23.2 | 0 | 0.05 | 49.62 | 0 | 677 | -189.8
0 | 2026-07-22 13:46:50 | 946685502 | 23.21 | 0 | 0.05 | 48.09 | 0 | 697 | -189.8
0 | 2026-07-22 13:47:10 | 946685523 | 23.21 | 0 | 0.05 | 46.91 | 0 | 718 | -189.8
0 | 2026-07-22 13:47:30 | 946685543 | 23.21 | 0 | 0.05 | 45.28 | 0 | 738 | -189.8
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
