COAST-Lab/c3po/Calibrations/Intercomparison Experiment/C3PO_2/2026_07_30_C3PO2.csv

Real_Time | Temp_C | Cond_uScm-1 | CellVoltage | StateofCharge | ErrorCode
946684805 | 24.63 | 0.00 | 0.66 | 96.55 | 0
946684822 | 24.64 | 0.00 | 0.05 | 95.13 | 0
946684843 | 24.78 | 0.00 | 0.05 | 93.55 | 0
946684863 | 24.78 | 0.00 | 0.05 | 92.12 | 0
946684883 | 24.83 | 0.00 | 0.04 | 90.54 | 0
946684902 | 25.12 | 0.00 | 0.04 | 89.12 | 0
946684922 | 27.94 | 0.00 | 0.04 | 87.64 | 0
946684943 | 31.09 | 608.00 | 0.04 | 86.20 | 0
946684963 | 30.18 | 0.00 | 0.04 | 84.77 | 0
Real_Time | Temp_C | Cond_uScm-1 | CellVoltage | StateofCharge | ErrorCode
946684805 | 27.38 | 0.00 | 4.11 | 84.48 | 0
Real_Time | Temp_C | Cond_uScm-1 | CellVoltage | StateofCharge | ErrorCode
946684805 | 22.61 | 0.00 | 0.55 | 98.29 | 0
946684823 | 22.80 | 0.00 | 0.05 | 96.87 | 0
946684843 | 22.94 | 0.00 | 0.04 | 95.45 | 0
946684863 | 23.15 | 0.00 | 0.04 | 93.86 | 0
946684882 | 23.32 | 0.00 | 0.04 | 92.44 | 0
946684902 | 23.36 | 0.00 | 0.04 | 91.02 | 0
946684922 | 23.33 | 0.00 | 0.04 | 89.43 | 0
946684943 | 23.19 | 0.00 | 0.04 | 87.93 | 0
946684963 | 23.34 | 0.00 | 0.04 | 86.34 | 0
946684982 | 23.35 | 0.00 | 0.04 | 84.91 | 0
946685002 | 23.34 | 0.00 | 0.04 | 83.36 | 0
946685022 | 23.33 | 0.00 | 0.04 | 81.89 | 0
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
