COAST-Lab/c3po/Calibrations/Intercomparison Experiment/C3PO_3/2026_07_30_C3PO3.csv

Real_Time | Temp_C | Cond_uScm-1 | CellVoltage | StateofCharge | ErrorCode
946684805 | 25.89 | 0.00 | 0.50 | 96.71 | 0
946684822 | 25.90 | 0.00 | 0.05 | 95.29 | 0
946684843 | 24.94 | 0.00 | 0.04 | 93.86 | 0
946684863 | 28.95 | 854.40 | 0.04 | 92.44 | 0
946684882 | 25.25 | 19730.00 | 0.04 | 90.86 | 0
946684902 | 23.23 | 19800.00 | 0.04 | 89.43 | 0
946684922 | 22.56 | 0.00 | 0.04 | 87.93 | 0
946684943 | 28.06 | 0.00 | 0.04 | 86.49 | 0
Real_Time | Temp_C | Cond_uScm-1 | CellVoltage | StateofCharge | ErrorCode
Real_Time | Temp_C | Cond_uScm-1 | CellVoltage | StateofCharge | ErrorCode
946684805 | 20.32 | 0.00 | 0.45 | 97.03 | 0
946684823 | 20.31 | 0.00 | 0.04 | 95.60 | 0
946684843 | 19.90 | 0.00 | 0.04 | 94.18 | 0
946684863 | 19.73 | 0.00 | 0.04 | 92.60 | 0
946684882 | 21.39 | 0.00 | 0.04 | 91.17 | 0
946684902 | 22.73 | 0.00 | 0.04 | 89.59 | 0
946684922 | 22.88 | 0.00 | 0.04 | 88.07 | 0
946684943 | 22.97 | 0.00 | 0.04 | 86.63 | 0
946684963 | 23.16 | 0.00 | 0.04 | 85.20 | 0
946684982 | 23.15 | 0.00 | 0.04 | 83.68 | 0
946685002 | 23.15 | 0.00 | 0.04 | 82.21 | 0
946685022 | 23.16 | 0.00 | 0.04 | 80.75 | 0
946685043 | 23.14 | 0.00 | 0.04 | 79.28 | 0
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
