COAST-Lab/c3po/Calibrations/Intercomparison Experiment/C3PO_4/2026_07_30_C3PO4.csv

Real_Time | Temp_C | Cond_uScm-1 | CellVoltage | StateofCharge | ErrorCode
946684805 | 26.01 | 0.00 | 0.62 | 82.70 | 0
946684822 | 25.98 | 0.00 | 0.05 | 81.24 | 0
946684843 | 25.38 | 0.00 | 0.05 | 79.61 | 0
946684863 | 28.45 | 1638.00 | 0.05 | 78.14 | 0
946684882 | 27.84 | 53280.00 | 0.05 | 76.67 | 0
946684902 | 29.36 | 829.70 | 0.05 | 75.20 | 0
946684922 | 31.37 | 835.20 | 0.05 | 73.73 | 0
946684943 | 29.24 | 0.00 | 0.05 | 72.25 | 0
946684963 | 27.14 | 0.00 | 0.05 | 70.77 | 0
Real_Time | Temp_C | Cond_uScm-1 | CellVoltage | StateofCharge | ErrorCode
946684805 | 23.28 | 0.00 | 0.58 | 95.76 | 0
946684823 | 23.45 | 0.00 | 0.05 | 94.50 | 0
946684843 | 23.47 | 0.00 | 0.04 | 93.07 | 0
946684863 | 23.54 | 0.00 | 0.04 | 91.49 | 0
946684882 | 23.67 | 0.00 | 0.04 | 89.91 | 0
946684902 | 23.49 | 0.00 | 0.04 | 88.50 | 0
946684923 | 23.53 | 0.00 | 0.04 | 86.92 | 0
946684943 | 23.74 | 0.00 | 0.04 | 85.48 | 0
946684962 | 23.83 | 0.00 | 0.04 | 84.01 | 0
946684982 | 23.82 | 0.00 | 0.04 | 82.38 | 0
946685002 | 23.73 | 0.00 | 0.04 | 80.91 | 0
946685023 | 23.73 | 0.00 | 0.04 | 79.28 | 0
946685043 | 23.74 | 0.00 | 0.04 | 77.65 | 0
946685062 | 23.74 | 0.00 | 0.04 | 76.18 | 0
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
