COAST-Lab/c3po/Calibrations/Intercomparison Experiment/C3PO_5/2026_07_30_C3PO5.csv

Real_Time | Temp_C | Cond_uScm-1 | CellVoltage | StateofCharge | ErrorCode
946684805 | 24.65 | 0.00 | 0.61 | 94.81 | 0
946684823 | 24.50 | 0.00 | 0.05 | 93.55 | 0
946684843 | 24.49 | 0.00 | 0.04 | 91.96 | 0
946684863 | 24.50 | 0.00 | 0.04 | 90.38 | 0
946684882 | 24.52 | 0.00 | 0.04 | 88.96 | 0
946684902 | 26.28 | 0.00 | 0.04 | 87.49 | 0
946684923 | 29.03 | 0.00 | 0.04 | 86.06 | 0
946684943 | 28.61 | 0.00 | 0.04 | 84.48 | 0
946684962 | 28.27 | 0.00 | 0.04 | 83.03 | 0
946684982 | 27.97 | 0.00 | 0.04 | 81.40 | 0
946685002 | 27.56 | 0.00 | 0.04 | 79.93 | 0
946685023 | 27.40 | 0.00 | 0.04 | 78.46 | 0
946685043 | 27.15 | 0.00 | 0.04 | 77.00 | 0
946685062 | 26.70 | 0.00 | 0.04 | 75.37 | 0
946685082 | 30.15 | 0.00 | 0.04 | 73.89 | 0
946685103 | 33.54 | 330.80 | 0.04 | 72.41 | 0
946685123 | 32.45 | 0.00 | 0.04 | 70.94 | 0
946685143 | 28.61 | 0.00 | 0.04 | 69.46 | 0
Real_Time | Temp_C | Cond_uScm-1 | CellVoltage | StateofCharge | ErrorCode
946684806 | 0.00 | 0.00 | 4.08 | 86.78 | 0
Real_Time | Temp_C | Cond_uScm-1 | CellVoltage | StateofCharge | ErrorCode
946684805 | 23.91 | 0.00 | 4.08 | 86.78 | 0
946684822 | 23.81 | 0.00 | 4.08 | 86.78 | 0
946684843 | 23.65 | 0.00 | 4.08 | 86.49 | 0
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
