COAST-Lab/c3po/Calibrations/Intercomparison Experiment/C3PO_6/2026_07_30_C3PO6.csv

Real_Time | Temp_C | Cond_uScm-1 | CellVoltage | StateofCharge | ErrorCode
Real_Time | Temp_C | Cond_uScm-1 | CellVoltage | StateofCharge | ErrorCode
946684805 | 23.59 | 0.00 | 0.92 | 0.00 | 0
946684822 | 23.59 | 0.00 | 0.06 | 0.00 | 0
946684843 | 23.60 | 0.00 | 0.05 | 0.00 | 0
946684863 | 24.07 | 0.00 | 0.05 | 0.00 | 0
946684883 | 25.93 | 0.00 | 0.05 | 0.00 | 0
946684902 | 31.07 | 0.00 | 0.05 | 0.00 | 0
946684922 | 29.95 | 0.00 | 0.05 | 0.00 | 0
946684943 | 26.60 | 0.00 | 0.05 | 0.00 | 0
946684963 | 24.51 | 0.00 | 0.05 | 0.00 | 0
946684983 | 23.61 | 0.00 | 0.05 | 0.00 | 0
946685002 | 22.99 | 0.00 | 0.05 | 0.00 | 0
946685022 | 22.53 | 0.00 | 0.05 | 0.00 | 0
946685043 | 22.25 | 0.00 | 0.05 | 0.00 | 0
946685063 | 22.07 | 0.00 | 0.05 | 0.00 | 0
946685082 | 22.05 | 0.00 | 0.05 | 0.00 | 0
946685102 | 22.04 | 0.00 | 0.05 | 0.00 | 0
946685122 | 22.03 | 0.00 | 0.05 | 0.00 | 0
946685143 | 22.03 | 0.00 | 0.05 | 0.00 | 0
946685163 | 22.04 | 0.00 | 0.05 | 0.00 | 0
946685183 | 22.06 | 0.00 | 0.05 | 0.00 | 0
946685202 | 22.08 | 0.00 | 0.05 | 0.00 | 0
946685222 | 22.29 | 0.00 | 0.05 | 0.00 | 0
946685243 | 22.45 | 0.00 | 0.05 | 0.00 | 0
946685263 | 25.90 | 0.00 | 0.05 | 0.00 | 0
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
