COAST-Lab/c3po/Calibrations/C3PO_2/2025_12_22_Calibration/conductivity.csv

Real_Time | Temp_C | Cond_uScm-1 | CellVoltage | StateofCharge | ErrorCode | Elapsed_sec | datetime
946684806 | 0 | 0 | 3.86 | 57.26 | 0 | 0 | 2025-12-22 10:55:06
946684823 | 22.68 | 0 | 3.94 | 57.26 | 0 | 17 | 2025-12-22 10:55:23
946684842 | 22.89 | 0 | 3.95 | 57.26 | 0 | 36 | 2025-12-22 10:55:42
946684862 | 22.89 | 0 | 3.95 | 57.26 | 0 | 56 | 2025-12-22 10:56:02
946684882 | 22.92 | 0 | 3.95 | 57.26 | 0 | 76 | 2025-12-22 10:56:22
946684903 | 22.74 | 0 | 3.95 | 57.26 | 0 | 97 | 2025-12-22 10:56:43
946684923 | 22.79 | 0 | 3.95 | 57.26 | 0 | 117 | 2025-12-22 10:57:03
946684943 | 22.65 | 0 | 3.95 | 57.26 | 0 | 137 | 2025-12-22 10:57:23
946684962 | 22.68 | 0 | 3.96 | 57.26 | 0 | 156 | 2025-12-22 10:57:42
946684982 | 22.68 | 0 | 3.96 | 57.26 | 0 | 176 | 2025-12-22 10:58:02
946685003 | 22.14 | 0 | 3.96 | 57.58 | 0 | 197 | 2025-12-22 10:58:23
946685023 | 21.98 | 0 | 3.96 | 57.58 | 0 | 217 | 2025-12-22 10:58:43
946685043 | 22.17 | 0 | 3.96 | 57.58 | 0 | 237 | 2025-12-22 10:59:03
946685062 | 22.4 | 0 | 3.96 | 57.58 | 0 | 256 | 2025-12-22 10:59:22
946685082 | 22.45 | 0 | 3.96 | 57.58 | 0 | 276 | 2025-12-22 10:59:42
946685102 | 22.59 | 0 | 3.96 | 57.58 | 0 | 296 | 2025-12-22 11:00:02
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
