COAST-Lab/c3po/Calibrations/C3PO_2/2025_12_22_Calibration/merged.csv

cond_uscm | datetime | Real_Time | Temp_C | Cond_uScm-1 | CellVoltage | StateofCharge | ErrorCode | Elapsed_sec
0 | 2025-12-22 10:59:04 | 946685043 | 22.17 | 0 | 3.96 | 57.58 | 0 | 237
0 | 2025-12-22 10:59:24 | 946685062 | 22.4 | 0 | 3.96 | 57.58 | 0 | 256
0 | 2025-12-22 10:59:44 | 946685082 | 22.45 | 0 | 3.96 | 57.58 | 0 | 276
0 | 2025-12-22 11:00:04 | 946685102 | 22.59 | 0 | 3.96 | 57.58 | 0 | 296
0 | 2025-12-22 11:00:24 | 946685123 | 22.59 | 0 | 3.96 | 57.58 | 0 | 317
0 | 2025-12-22 11:00:44 | 946685143 | 22.58 | 0 | 3.96 | 57.58 | 0 | 337
0 | 2025-12-22 11:01:04 | 946685162 | 22.55 | 0 | 3.97 | 57.89 | 0 | 356
0 | 2025-12-22 11:01:24 | 946685182 | 22.55 | 0 | 3.97 | 57.89 | 0 | 376
0 | 2025-12-22 11:01:44 | 946685202 | 22.55 | 0 | 3.97 | 57.89 | 0 | 396
0 | 2025-12-22 11:02:04 | 946685223 | 22.56 | 0 | 3.97 | 57.89 | 0 | 417
0 | 2025-12-22 11:02:24 | 946685243 | 22.39 | 0 | 3.97 | 57.89 | 0 | 437
0 | 2025-12-22 11:02:44 | 946685263 | 22.58 | 0 | 3.97 | 57.89 | 0 | 457
0 | 2025-12-22 11:03:04 | 946685282 | 22.58 | 0 | 3.97 | 57.89 | 0 | 476
0 | 2025-12-22 11:03:24 | 946685302 | 22.57 | 0 | 3.97 | 58.21 | 0 | 496
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
