COAST-Lab/c3po/Calibrations/C3PO_2/2026_07_22_ReCalibration/conductivity.csv

Real_Time | Temp_C | Cond_uScm-1 | CellVoltage | StateofCharge | ErrorCode | Elapsed_sec | datetime
946684805 | 22.61 | 0 | 0.55 | 98.29 | 0 | 0 | 2026-07-22 15:28:21
946684823 | 22.8 | 0 | 0.05 | 96.87 | 0 | 18 | 2026-07-22 15:28:39
946684843 | 22.94 | 0 | 0.04 | 95.45 | 0 | 38 | 2026-07-22 15:28:59
946684863 | 23.15 | 0 | 0.04 | 93.86 | 0 | 58 | 2026-07-22 15:29:19
946684882 | 23.32 | 0 | 0.04 | 92.44 | 0 | 77 | 2026-07-22 15:29:38
946684902 | 23.36 | 0 | 0.04 | 91.02 | 0 | 97 | 2026-07-22 15:29:58
946684922 | 23.33 | 0 | 0.04 | 89.43 | 0 | 117 | 2026-07-22 15:30:18
946684943 | 23.19 | 0 | 0.04 | 87.93 | 0 | 138 | 2026-07-22 15:30:39
946684963 | 23.34 | 0 | 0.04 | 86.34 | 0 | 158 | 2026-07-22 15:30:59
946684982 | 23.35 | 0 | 0.04 | 84.91 | 0 | 177 | 2026-07-22 15:31:18
946685002 | 23.34 | 0 | 0.04 | 83.36 | 0 | 197 | 2026-07-22 15:31:38
946685022 | 23.33 | 0 | 0.04 | 81.89 | 0 | 217 | 2026-07-22 15:31:58
946685043 | 23.32 | 0 | 0.04 | 80.42 | 0 | 238 | 2026-07-22 15:32:19
946685063 | 23.38 | 0 | 0.04 | 78.95 | 0 | 258 | 2026-07-22 15:32:39
946685082 | 23.38 | 0 | 0.04 | 77.48 | 0 | 277 | 2026-07-22 15:32:58
946685102 | 23.46 | 0 | 0.04 | 75.86 | 0 | 297 | 2026-07-22 15:33:18
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
