COAST-Lab/c3po/Calibrations/C3PO_3/2025_12_22_Calibration/conductivity.csv

Real_Time | Temp_C | Cond_uScm-1 | CellVoltage | StateofCharge | ErrorCode | Elapsed_sec | datetime
946684806 | 0 | 0 | 3.86 | 57.26 | 0 | 0 | 2025-12-22 11:21:46
946684823 | 0 | 0 | 3.86 | 57.26 | 0 | 17 | 2025-12-22 11:22:03
946684842 | 22.28 | 0 | 3.94 | 57.26 | 0 | 36 | 2025-12-22 11:22:22
946684863 | 22.4 | 0 | 3.95 | 57.26 | 0 | 57 | 2025-12-22 11:22:43
946684883 | 22.1 | 0 | 3.95 | 57.26 | 0 | 77 | 2025-12-22 11:23:03
946684903 | 21.98 | 0 | 3.95 | 57.26 | 0 | 97 | 2025-12-22 11:23:23
946684922 | 21.98 | 0 | 3.96 | 57.26 | 0 | 116 | 2025-12-22 11:23:42
946684942 | 21.99 | 0 | 3.96 | 57.26 | 0 | 136 | 2025-12-22 11:24:02
946684962 | 21.99 | 0 | 3.96 | 57.26 | 0 | 156 | 2025-12-22 11:24:22
946684983 | 21.98 | 0 | 3.96 | 57.26 | 0 | 177 | 2025-12-22 11:24:43
946685003 | 21.98 | 0 | 3.96 | 57.26 | 0 | 197 | 2025-12-22 11:25:03
946685022 | 21.98 | 0 | 3.96 | 57.58 | 0 | 216 | 2025-12-22 11:25:22
946685042 | 22.06 | 0 | 3.96 | 57.58 | 0 | 236 | 2025-12-22 11:25:42
946685062 | 21.83 | 0 | 3.97 | 57.58 | 0 | 256 | 2025-12-22 11:26:02
946685083 | 22.03 | 0 | 3.97 | 57.58 | 0 | 277 | 2025-12-22 11:26:23
946685103 | 21.89 | 0 | 3.97 | 57.58 | 0 | 297 | 2025-12-22 11:26:43
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
