COAST-Lab/c3po/Calibrations/C3PO_3/2025_12_22_Calibration/merged.csv

cond_uscm | datetime | Real_Time | Temp_C | Cond_uScm-1 | CellVoltage | StateofCharge | ErrorCode | Elapsed_sec
0 | 2025-12-22 11:22:58 | 946684883 | 22.1 | 0 | 3.95 | 57.26 | 0 | 77
0 | 2025-12-22 11:23:18 | 946684903 | 21.98 | 0 | 3.95 | 57.26 | 0 | 97
0 | 2025-12-22 11:23:38 | 946684922 | 21.98 | 0 | 3.96 | 57.26 | 0 | 116
0 | 2025-12-22 11:23:58 | 946684942 | 21.99 | 0 | 3.96 | 57.26 | 0 | 136
0 | 2025-12-22 11:24:18 | 946684962 | 21.99 | 0 | 3.96 | 57.26 | 0 | 156
0 | 2025-12-22 11:24:38 | 946684983 | 21.98 | 0 | 3.96 | 57.26 | 0 | 177
0 | 2025-12-22 11:24:58 | 946685003 | 21.98 | 0 | 3.96 | 57.26 | 0 | 197
0 | 2025-12-22 11:25:18 | 946685022 | 21.98 | 0 | 3.96 | 57.58 | 0 | 216
0 | 2025-12-22 11:25:38 | 946685042 | 22.06 | 0 | 3.96 | 57.58 | 0 | 236
0 | 2025-12-22 11:25:58 | 946685062 | 21.83 | 0 | 3.97 | 57.58 | 0 | 256
0 | 2025-12-22 11:26:18 | 946685083 | 22.03 | 0 | 3.97 | 57.58 | 0 | 277
0 | 2025-12-22 11:26:38 | 946685103 | 21.89 | 0 | 3.97 | 57.58 | 0 | 297
0 | 2025-12-22 11:26:58 | 946685123 | 22.04 | 0 | 3.97 | 57.58 | 0 | 317
0 | 2025-12-22 11:27:18 | 946685142 | 21.83 | 0 | 3.97 | 57.58 | 0 | 336
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
