COAST-Lab/c3po/Calibrations/C3PO_3/2026_07_22_ReCalibration/conductivity.csv

Real_Time | Temp_C | Cond_uScm-1 | CellVoltage | StateofCharge | ErrorCode | Elapsed_sec | datetime
946684805 | 20.32 | 0 | 0.45 | 97.03 | 0 | 0 | 2026-07-22 14:59:32
946684823 | 20.31 | 0 | 0.04 | 95.6 | 0 | 18 | 2026-07-22 14:59:50
946684843 | 19.9 | 0 | 0.04 | 94.18 | 0 | 38 | 2026-07-22 15:00:10
946684863 | 19.73 | 0 | 0.04 | 92.6 | 0 | 58 | 2026-07-22 15:00:30
946684882 | 21.39 | 0 | 0.04 | 91.17 | 0 | 77 | 2026-07-22 15:00:49
946684902 | 22.73 | 0 | 0.04 | 89.59 | 0 | 97 | 2026-07-22 15:01:09
946684922 | 22.88 | 0 | 0.04 | 88.07 | 0 | 117 | 2026-07-22 15:01:29
946684943 | 22.97 | 0 | 0.04 | 86.63 | 0 | 138 | 2026-07-22 15:01:50
946684963 | 23.16 | 0 | 0.04 | 85.2 | 0 | 158 | 2026-07-22 15:02:10
946684982 | 23.15 | 0 | 0.04 | 83.68 | 0 | 177 | 2026-07-22 15:02:29
946685002 | 23.15 | 0 | 0.04 | 82.21 | 0 | 197 | 2026-07-22 15:02:49
946685022 | 23.16 | 0 | 0.04 | 80.75 | 0 | 217 | 2026-07-22 15:03:09
946685043 | 23.14 | 0 | 0.04 | 79.28 | 0 | 238 | 2026-07-22 15:03:30
946685063 | 23.14 | 0 | 0.04 | 77.81 | 0 | 258 | 2026-07-22 15:03:50
946685083 | 23.15 | 0 | 0.04 | 76.18 | 0 | 278 | 2026-07-22 15:04:10
946685102 | 23.16 | 0 | 0.04 | 74.71 | 0 | 297 | 2026-07-22 15:04:29
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
