COAST-Lab/c3po/Calibrations/C3PO_3/2026_07_22_ReCalibration/merged.csv

cond_uscm | datetime | Real_Time | Temp_C | Cond_uScm-1 | CellVoltage | StateofCharge | ErrorCode | Elapsed_sec
0 | 2026-07-22 15:00:45 | 946684882 | 21.39 | 0 | 0.04 | 91.17 | 0 | 77
0 | 2026-07-22 15:01:05 | 946684902 | 22.73 | 0 | 0.04 | 89.59 | 0 | 97
0 | 2026-07-22 15:01:25 | 946684922 | 22.88 | 0 | 0.04 | 88.07 | 0 | 117
0 | 2026-07-22 15:01:45 | 946684943 | 22.97 | 0 | 0.04 | 86.63 | 0 | 138
0 | 2026-07-22 15:02:05 | 946684963 | 23.16 | 0 | 0.04 | 85.2 | 0 | 158
0 | 2026-07-22 15:02:25 | 946684982 | 23.15 | 0 | 0.04 | 83.68 | 0 | 177
0 | 2026-07-22 15:02:45 | 946685002 | 23.15 | 0 | 0.04 | 82.21 | 0 | 197
0 | 2026-07-22 15:03:05 | 946685022 | 23.16 | 0 | 0.04 | 80.75 | 0 | 217
0 | 2026-07-22 15:03:25 | 946685043 | 23.14 | 0 | 0.04 | 79.28 | 0 | 238
0 | 2026-07-22 15:03:45 | 946685063 | 23.14 | 0 | 0.04 | 77.81 | 0 | 258
0 | 2026-07-22 15:04:05 | 946685083 | 23.15 | 0 | 0.04 | 76.18 | 0 | 278
0 | 2026-07-22 15:04:25 | 946685102 | 23.16 | 0 | 0.04 | 74.71 | 0 | 297
0 | 2026-07-22 15:04:45 | 946685122 | 23.31 | 0 | 0.04 | 73.4 | 0 | 317
0 | 2026-07-22 15:05:05 | 946685143 | 23.31 | 0 | 0.04 | 71.76 | 0 | 338
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
