COAST-Lab/c3po/Calibrations/C3PO_4/2025_12_22_Calibration/conductivity.csv

Real_Time | Temp_C | Cond_uScm-1 | CellVoltage | StateofCharge | ErrorCode | Elapsed_sec | datetime
946684806 | 0 | 0 | 3.86 | 57.26 | 0 | 0 | 2025-12-22 11:44:43
946684823 | 23.2 | 0 | 3.94 | 57.26 | 0 | 17 | 2025-12-22 11:45:00
946684842 | 24.66 | 0 | 3.94 | 57.26 | 0 | 36 | 2025-12-22 11:45:19
946684862 | 24.82 | 0 | 3.95 | 57.26 | 0 | 56 | 2025-12-22 11:45:39
946684882 | 24.57 | 0 | 3.95 | 57.26 | 0 | 76 | 2025-12-22 11:45:59
946684903 | 24.61 | 0 | 3.95 | 57.26 | 0 | 97 | 2025-12-22 11:46:20
946684923 | 24.63 | 0 | 3.95 | 57.26 | 0 | 117 | 2025-12-22 11:46:40
946684942 | 24.62 | 0 | 3.95 | 57.26 | 0 | 136 | 2025-12-22 11:46:59
946684962 | 24.6 | 0 | 3.96 | 57.26 | 0 | 156 | 2025-12-22 11:47:19
946684982 | 24.47 | 0 | 3.96 | 57.26 | 0 | 176 | 2025-12-22 11:47:39
946685003 | 24.47 | 0 | 3.96 | 57.58 | 0 | 197 | 2025-12-22 11:48:00
946685023 | 24.33 | 0 | 3.96 | 57.58 | 0 | 217 | 2025-12-22 11:48:20
946685043 | 24.34 | 0 | 3.96 | 57.58 | 0 | 237 | 2025-12-22 11:48:40
946685062 | 24.35 | 0 | 3.96 | 57.58 | 0 | 256 | 2025-12-22 11:48:59
946685082 | 24.5 | 0 | 3.96 | 57.58 | 0 | 276 | 2025-12-22 11:49:19
946685103 | 24.86 | 0 | 3.96 | 57.58 | 0 | 297 | 2025-12-22 11:49:40
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
