COAST-Lab/c3po/Calibrations/C3PO_4/2025_12_22_Calibration/merged.csv

cond_uscm | datetime | Real_Time | Temp_C | Cond_uScm-1 | CellVoltage | StateofCharge | ErrorCode | Elapsed_sec
0 | 2025-12-22 11:45:14 | 946684842 | 24.66 | 0 | 3.94 | 57.26 | 0 | 36
0 | 2025-12-22 11:45:34 | 946684862 | 24.82 | 0 | 3.95 | 57.26 | 0 | 56
0 | 2025-12-22 11:45:54 | 946684882 | 24.57 | 0 | 3.95 | 57.26 | 0 | 76
0 | 2025-12-22 11:46:14 | 946684903 | 24.61 | 0 | 3.95 | 57.26 | 0 | 97
0 | 2025-12-22 11:46:34 | 946684923 | 24.63 | 0 | 3.95 | 57.26 | 0 | 117
0 | 2025-12-22 11:46:54 | 946684942 | 24.62 | 0 | 3.95 | 57.26 | 0 | 136
0 | 2025-12-22 11:47:14 | 946684962 | 24.6 | 0 | 3.96 | 57.26 | 0 | 156
0 | 2025-12-22 11:47:34 | 946684982 | 24.47 | 0 | 3.96 | 57.26 | 0 | 176
0 | 2025-12-22 11:47:54 | 946685003 | 24.47 | 0 | 3.96 | 57.58 | 0 | 197
0 | 2025-12-22 11:48:14 | 946685023 | 24.33 | 0 | 3.96 | 57.58 | 0 | 217
0 | 2025-12-22 11:48:34 | 946685043 | 24.34 | 0 | 3.96 | 57.58 | 0 | 237
0 | 2025-12-22 11:48:54 | 946685062 | 24.35 | 0 | 3.96 | 57.58 | 0 | 256
0 | 2025-12-22 11:49:14 | 946685082 | 24.5 | 0 | 3.96 | 57.58 | 0 | 276
0 | 2025-12-22 11:49:34 | 946685103 | 24.86 | 0 | 3.96 | 57.58 | 0 | 297
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
