COAST-Lab/c3po/Calibrations/C3PO_4/2026_07_22_ReCalibration/conductivity.csv

Real_Time | Temp_C | Cond_uScm-1 | CellVoltage | StateofCharge | ErrorCode | Elapsed_sec | datetime
946684805 | 23.28 | 0 | 0.58 | 95.76 | 0 | 0 | 2026-07-22 14:33:49
946684823 | 23.45 | 0 | 0.05 | 94.5 | 0 | 18 | 2026-07-22 14:34:07
946684843 | 23.47 | 0 | 0.04 | 93.07 | 0 | 38 | 2026-07-22 14:34:27
946684863 | 23.54 | 0 | 0.04 | 91.49 | 0 | 58 | 2026-07-22 14:34:47
946684882 | 23.67 | 0 | 0.04 | 89.91 | 0 | 77 | 2026-07-22 14:35:06
946684902 | 23.49 | 0 | 0.04 | 88.5 | 0 | 97 | 2026-07-22 14:35:26
946684923 | 23.53 | 0 | 0.04 | 86.92 | 0 | 118 | 2026-07-22 14:35:47
946684943 | 23.74 | 0 | 0.04 | 85.48 | 0 | 138 | 2026-07-22 14:36:07
946684962 | 23.83 | 0 | 0.04 | 84.01 | 0 | 157 | 2026-07-22 14:36:26
946684982 | 23.82 | 0 | 0.04 | 82.38 | 0 | 177 | 2026-07-22 14:36:46
946685002 | 23.73 | 0 | 0.04 | 80.91 | 0 | 197 | 2026-07-22 14:37:06
946685023 | 23.73 | 0 | 0.04 | 79.28 | 0 | 218 | 2026-07-22 14:37:27
946685043 | 23.74 | 0 | 0.04 | 77.65 | 0 | 238 | 2026-07-22 14:37:47
946685062 | 23.74 | 0 | 0.04 | 76.18 | 0 | 257 | 2026-07-22 14:38:06
946685082 | 23.75 | 0 | 0.04 | 74.71 | 0 | 277 | 2026-07-22 14:38:26
946685102 | 23.85 | 0 | 0.04 | 73.23 | 0 | 297 | 2026-07-22 14:38:46
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
