COAST-Lab/c3po/Calibrations/C3PO_4/2026_07_22_ReCalibration/merged.csv

cond_uscm | datetime | Real_Time | Temp_C | Cond_uScm-1 | CellVoltage | StateofCharge | ErrorCode | Elapsed_sec
0 | 2026-07-22 14:37:00 | 946685002 | 23.73 | 0 | 0.04 | 80.91 | 0 | 197
0 | 2026-07-22 14:37:20 | 946685023 | 23.73 | 0 | 0.04 | 79.28 | 0 | 218
0 | 2026-07-22 14:37:40 | 946685043 | 23.74 | 0 | 0.04 | 77.65 | 0 | 238
0 | 2026-07-22 14:38:00 | 946685062 | 23.74 | 0 | 0.04 | 76.18 | 0 | 257
0 | 2026-07-22 14:38:20 | 946685082 | 23.75 | 0 | 0.04 | 74.71 | 0 | 277
0 | 2026-07-22 14:38:40 | 946685102 | 23.85 | 0 | 0.04 | 73.23 | 0 | 297
0 | 2026-07-22 14:39:00 | 946685123 | 23.7 | 0 | 0.04 | 71.76 | 0 | 318
0 | 2026-07-22 14:39:20 | 946685143 | 23.99 | 0 | 0.04 | 70.28 | 0 | 338
0 | 2026-07-22 14:39:40 | 946685162 | 23.81 | 0 | 0.04 | 68.97 | 0 | 357
0 | 2026-07-22 14:40:00 | 946685182 | 23.94 | 0 | 0.04 | 67.45 | 0 | 377
0 | 2026-07-22 14:40:20 | 946685202 | 23.8 | 0 | 0.05 | 66.14 | 0 | 397
0 | 2026-07-22 14:40:40 | 946685223 | 24.01 | 0 | 0.04 | 64.7 | 0 | 418
0 | 2026-07-22 14:41:00 | 946685243 | 23.7 | 0 | 0.04 | 63.4 | 0 | 438
0 | 2026-07-22 14:41:20 | 946685262 | 23.92 | 0 | 0.04 | 61.95 | 0 | 457
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
