COAST-Lab/c3po/Calibrations/C3PO_5/2025_12_22_Calibration/conductivity.csv

Real_Time | Temp_C | Cond_uScm-1 | CellVoltage | StateofCharge | ErrorCode | Elapsed_sec | datetime
946684806 | 0 | 0 | 3.86 | 56 | 0 | 0 | 2025-12-22 12:06:08
946684823 | 20.28 | 0 | 3.94 | 56 | 0 | 17 | 2025-12-22 12:06:25
946684843 | 20.57 | 0 | 3.94 | 56 | 0 | 37 | 2025-12-22 12:06:45
946684862 | 21.13 | 0 | 3.95 | 56 | 0 | 56 | 2025-12-22 12:07:04
946684882 | 21.25 | 0 | 3.95 | 56 | 0 | 76 | 2025-12-22 12:07:24
946684903 | 21.26 | 0 | 3.95 | 56 | 0 | 97 | 2025-12-22 12:07:45
946684923 | 21.26 | 0 | 3.95 | 56 | 0 | 117 | 2025-12-22 12:08:05
946684943 | 21.27 | 0 | 3.95 | 56 | 0 | 137 | 2025-12-22 12:08:25
946684962 | 21.27 | 0 | 3.95 | 56 | 0 | 156 | 2025-12-22 12:08:44
946684982 | 21.19 | 0 | 3.96 | 56.31 | 0 | 176 | 2025-12-22 12:09:04
946685002 | 21.34 | 0 | 3.96 | 56.31 | 0 | 196 | 2025-12-22 12:09:24
946685023 | 21.11 | 0 | 3.96 | 56.31 | 0 | 217 | 2025-12-22 12:09:45
946685043 | 21.43 | 0 | 3.96 | 56.31 | 0 | 237 | 2025-12-22 12:10:05
946685062 | 21.22 | 0 | 3.96 | 56.31 | 0 | 256 | 2025-12-22 12:10:24
946685082 | 21.18 | 0 | 3.96 | 56.31 | 0 | 276 | 2025-12-22 12:10:44
946685102 | 21.2 | 0 | 3.96 | 56.31 | 0 | 296 | 2025-12-22 12:11:04
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
