COAST-Lab/c3po/Calibrations/C3PO_5/2026_07_22_ReCalibration/conductivity.csv

Real_Time | Temp_C | Cond_uScm-1 | CellVoltage | StateofCharge | ErrorCode | Elapsed_sec | datetime
946684805 | 22.82 | 0 | 0.54 | 95.76 | 0 | 0 | 2026-07-22 14:09:16
946684823 | 23.12 | 0 | 0.05 | 94.34 | 0 | 18 | 2026-07-22 14:09:34
946684843 | 23.12 | 0 | 0.04 | 92.91 | 0 | 38 | 2026-07-22 14:09:54
946684863 | 23.11 | 0 | 0.04 | 91.49 | 0 | 58 | 2026-07-22 14:10:14
946684882 | 23.11 | 0 | 0.04 | 90.07 | 0 | 77 | 2026-07-22 14:10:33
946684902 | 23.24 | 0 | 0.04 | 88.5 | 0 | 97 | 2026-07-22 14:10:53
946684923 | 23.23 | 0 | 0.04 | 87.06 | 0 | 118 | 2026-07-22 14:11:14
946684943 | 23.18 | 0 | 0.04 | 85.63 | 0 | 138 | 2026-07-22 14:11:34
946684963 | 23.32 | 0 | 0.04 | 84.17 | 0 | 158 | 2026-07-22 14:11:54
946684982 | 23.39 | 0 | 0.04 | 82.7 | 0 | 177 | 2026-07-22 14:12:13
946685002 | 23.4 | 0 | 0.04 | 81.07 | 0 | 197 | 2026-07-22 14:12:33
946685023 | 23.33 | 0 | 0.04 | 79.61 | 0 | 218 | 2026-07-22 14:12:54
946685043 | 23.18 | 0 | 0.04 | 78.14 | 0 | 238 | 2026-07-22 14:13:14
946685063 | 23.35 | 0 | 0.04 | 76.67 | 0 | 258 | 2026-07-22 14:13:34
946685082 | 23.23 | 0 | 0.04 | 75.2 | 0 | 277 | 2026-07-22 14:13:53
946685102 | 23.23 | 0 | 0.04 | 73.73 | 0 | 297 | 2026-07-22 14:14:13
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
