COAST-Lab/c3po/Calibrations/C3PO_5/2026_07_22_ReCalibration/merged.csv

cond_uscm | datetime | Real_Time | Temp_C | Cond_uScm-1 | CellVoltage | StateofCharge | ErrorCode | Elapsed_sec
0 | 2026-07-22 14:10:25 | 946684882 | 23.11 | 0 | 0.04 | 90.07 | 0 | 77
0 | 2026-07-22 14:10:45 | 946684902 | 23.24 | 0 | 0.04 | 88.5 | 0 | 97
0 | 2026-07-22 14:11:05 | 946684923 | 23.23 | 0 | 0.04 | 87.06 | 0 | 118
0 | 2026-07-22 14:11:25 | 946684943 | 23.18 | 0 | 0.04 | 85.63 | 0 | 138
0 | 2026-07-22 14:11:45 | 946684963 | 23.32 | 0 | 0.04 | 84.17 | 0 | 158
0 | 2026-07-22 14:12:05 | 946684982 | 23.39 | 0 | 0.04 | 82.7 | 0 | 177
0 | 2026-07-22 14:12:25 | 946685002 | 23.4 | 0 | 0.04 | 81.07 | 0 | 197
0 | 2026-07-22 14:12:45 | 946685023 | 23.33 | 0 | 0.04 | 79.61 | 0 | 218
0 | 2026-07-22 14:13:05 | 946685043 | 23.18 | 0 | 0.04 | 78.14 | 0 | 238
0 | 2026-07-22 14:13:25 | 946685063 | 23.35 | 0 | 0.04 | 76.67 | 0 | 258
0 | 2026-07-22 14:13:45 | 946685082 | 23.23 | 0 | 0.04 | 75.2 | 0 | 277
0 | 2026-07-22 14:14:05 | 946685102 | 23.23 | 0 | 0.04 | 73.73 | 0 | 297
0 | 2026-07-22 14:14:25 | 946685123 | 23.39 | 0 | 0.04 | 72.25 | 0 | 318
0 | 2026-07-22 14:14:45 | 946685143 | 23.15 | 0 | 0.04 | 70.77 | 0 | 338
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
