COAST-Lab/c3po/Calibrations/C3PO_6/2026_07_22_Calibration/conductivity.csv

Real_Time | Temp_C | Cond_uScm-1 | CellVoltage | StateofCharge | ErrorCode | Elapsed_sec | datetime
946684805 | 22.27 | 0 | 0.84 | 99.24 | 0 | 0 | 2026-07-22 13:35:10
946684823 | 22.4 | 0 | 0.05 | 97.82 | 0 | 18 | 2026-07-22 13:35:28
946684843 | 22.4 | 0 | 0.05 | 96.39 | 0 | 38 | 2026-07-22 13:35:48
946684862 | 22.4 | 0 | 0.05 | 94.81 | 0 | 57 | 2026-07-22 13:36:07
946684882 | 22.4 | 0 | 0.05 | 93.23 | 0 | 77 | 2026-07-22 13:36:27
946684902 | 22.4 | 0 | 0.05 | 91.8 | 0 | 97 | 2026-07-22 13:36:47
946684923 | 22.4 | 0 | 0.05 | 90.22 | 0 | 118 | 2026-07-22 13:37:08
946684943 | 22.4 | 0 | 0.05 | 88.64 | 0 | 138 | 2026-07-22 13:37:28
946684962 | 22.4 | 0 | 0.05 | 87.21 | 0 | 157 | 2026-07-22 13:37:47
946684982 | 22.4 | 0 | 0.05 | 85.77 | 0 | 177 | 2026-07-22 13:38:07
946685002 | 22.39 | 0 | 0.05 | 84.34 | 0 | 197 | 2026-07-22 13:38:27
946685023 | 22.39 | 0 | 0.05 | 82.7 | 0 | 218 | 2026-07-22 13:38:48
946685043 | 22.39 | 0 | 0.05 | 81.07 | 0 | 238 | 2026-07-22 13:39:08
946685063 | 22.4 | 0 | 0.05 | 79.77 | 0 | 258 | 2026-07-22 13:39:28
946685082 | 22.4 | 0 | 0.05 | 78.3 | 0 | 277 | 2026-07-22 13:39:47
946685102 | 22.4 | 0 | 0.05 | 76.83 | 0 | 297 | 2026-07-22 13:40:07
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
