COAST-Lab/c3po/Calibrations/C3PO_1/2025_04_23_Calibration/conductivity.csv

Real_Time | Temp_C | Cond_uScm-1 | Elapsed_sec | datetime
946684805 | 21.45 | 0 | 0 | 2025-4-23 12:32:22
946684822 | 21.46 | 0 | 17 | 2025-4-23 12:32:39
946684842 | 21.48 | 0 | 37 | 2025-4-23 12:32:59
946684862 | 21.49 | 0 | 57 | 2025-4-23 12:33:19
946684882 | 21.51 | 0 | 77 | 2025-4-23 12:33:39
946684902 | 21.53 | 0 | 97 | 2025-4-23 12:33:59
946684922 | 21.66 | 0 | 117 | 2025-4-23 12:34:19
946684942 | 21.95 | 0 | 137 | 2025-4-23 12:34:39
946684962 | 23.34 | 0 | 157 | 2025-4-23 12:34:59
946684982 | 23.65 | 0 | 177 | 2025-4-23 12:35:19
946685002 | 23.66 | 0 | 197 | 2025-4-23 12:35:39
946685022 | 23.67 | 0 | 217 | 2025-4-23 12:35:59
946685042 | 23.67 | 0 | 237 | 2025-4-23 12:36:19
946685062 | 23.67 | 0 | 257 | 2025-4-23 12:36:39
946685082 | 23.66 | 0 | 277 | 2025-4-23 12:36:59
946685102 | 23.65 | 0 | 297 | 2025-4-23 12:37:19
946685122 | 23.63 | 0 | 317 | 2025-4-23 12:37:39
946685142 | 23.61 | 0 | 337 | 2025-4-23 12:37:59
946685162 | 23.59 | 0 | 357 | 2025-4-23 12:38:19
946685182 | 23.57 | 0 | 377 | 2025-4-23 12:38:39
946685202 | 23.55 | 0 | 397 | 2025-4-23 12:38:59
946685222 | 23.52 | 0 | 417 | 2025-4-23 12:39:19
946685242 | 23.5 | 0 | 437 | 2025-4-23 12:39:39
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
