COAST-Lab/c3po/Data Analysis/Data/Kor Measurement File Export - 061526 180140_2026-06-14_2100_C3PO.csv

Kor MEASUREMENT DATA FILE EXPORT
FILE CREATED: | 6/15/2026 10:02:47 PM
MEAN VALUE: |  |  |  |  | 6.19 | 757.0 | 3.26 | 481.4 | 451.4 | 294 | 0.22 | 448.3 | -0.012 | -0.012 | -0.017 | 84.6 | 6.56 | 84.1 | 38.07 | 12.69 | 34.05348 | -77.88487 | 2.4 | NA | -60.5 | 12.0 | 0.00 | 28.469 | 21.29 | 0
STANDARD DEVIATION: |  |  |  |  | 1.06 | 0.1 | 0.19 | 539.6 | 505.9 | 329 | 0.28 | 502.2 | 0.001 | 0.004 | 0.001 | 1.7 | 0.16 | 1.7 | 2.94 | 0.98 | 0.00003 | 0.00002 | 4.6 | 0.01 | 0.6 | 0.0 | 0.00 | 0.239 | 42.86 | 0
SENSOR SERIAL NUMBER: |  |  |  |  | 23A100996 | 23A105694 | 23A100996 | 23E102415 | 23E102415 | 23E102415 | 23E102415 | 23E102415 | 22M102817 | 22M102817 | 22M102817 | 22M103265 | 22M103265 | 22M103265 | 23B100876 | 23B100876 | 23A105694 | 23A105694 | 23A105694 | 23B102284 | 23B102284 | 23A105694 | 23A105694 | 23E102415 | 23B100558 | 23B100558
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
