COAST-Lab/c3po/Data Analysis/Data/Kor Measurement File Export - 061526 180532_2026-06-14_2000_C3PO.csv

Kor MEASUREMENT DATA FILE EXPORT
FILE CREATED: | 6/15/2026 10:06:31 PM
MEAN VALUE: |  |  |  |  | 5.44 | 757.2 | 2.96 | 52596.7 | 48392.9 | 31455 | 31.44 | 47929.0 | -0.009 | -0.008 | -0.013 | 93.5 | 5.99 | 93.0 | 38.81 | 12.94 | 34.04633 | -77.88801 | 2.5 | NA | -63.4 | 12.0 | 0.00 | 29.548 | 13.01 | 0
STANDARD DEVIATION: |  |  |  |  | 0.52 | 0.1 | 0.29 | 87.4 | 71.3 | 46 | 0.05 | 70.5 | 0.001 | 0.004 | 0.001 | 0.3 | 0.02 | 0.3 | 1.61 | 0.54 | 0.00001 | 0.00001 | 1.9 | 0.01 | 0.4 | 0.0 | 0.00 | 0.038 | 1.96 | 0
SENSOR SERIAL NUMBER: |  |  |  |  | 23A100996 | 23A105694 | 23A100996 | 23E102415 | 23E102415 | 23E102415 | 23E102415 | 23E102415 | 22M102817 | 22M102817 | 22M102817 | 22M103265 | 22M103265 | 22M103265 | 23B100876 | 23B100876 | 23A105694 | 23A105694 | 23A105694 | 23B102284 | 23B102284 | 23A105694 | 23A105694 | 23E102415 | 23B100558 | 23B100558
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
