COAST-Lab/c3po/Calibrations/C3PO_1/2025_04_23_Calibration/Figures/C3PO_1_RawReadings.png

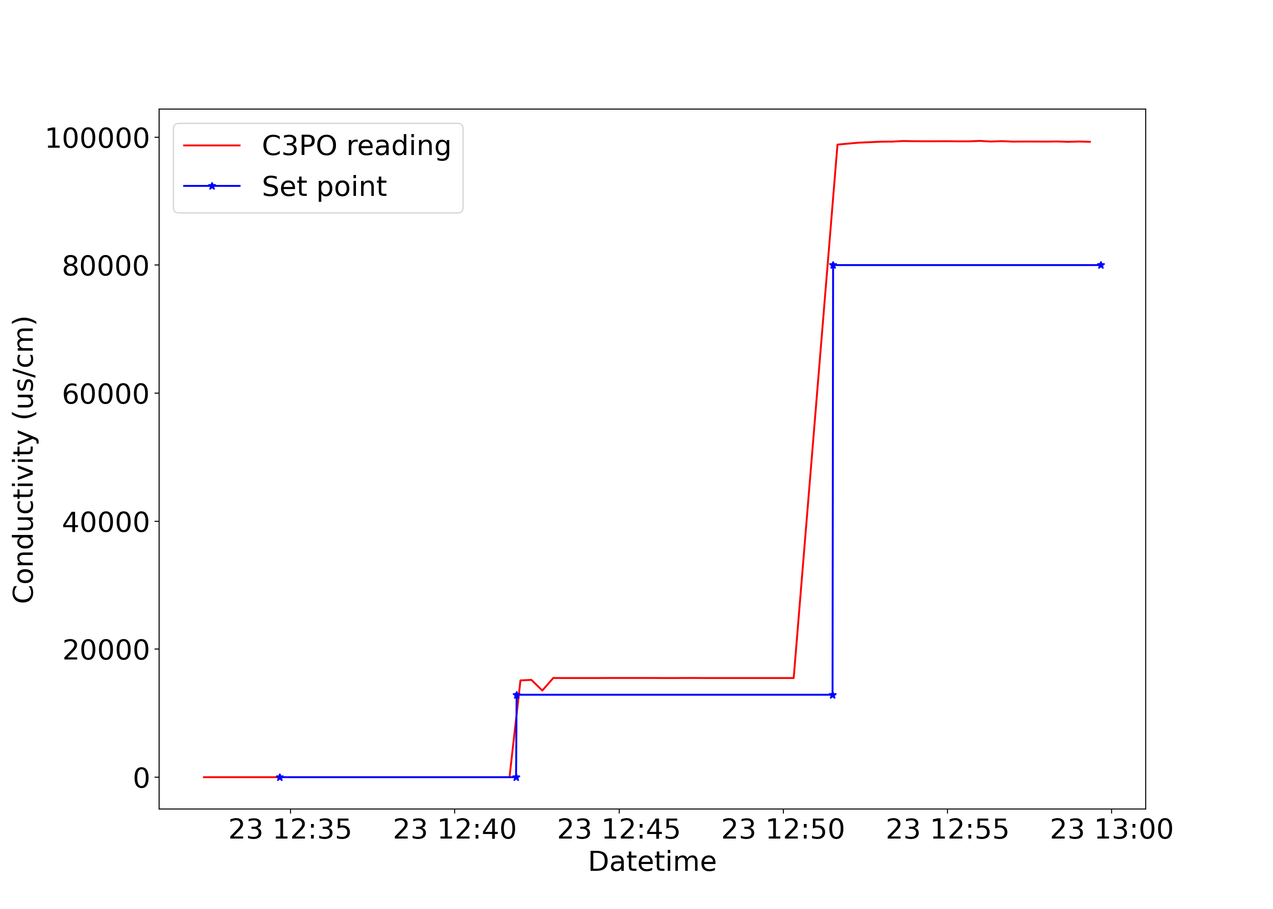
Calibrations/C3PO_1/2025_04_23_Calibration/Figures/C3PO_1_RawReadings.png
