COAST-Lab/c3po/Calibrations/C3PO_1/2025_04_23_Calibration/Figures/C3PO_1vsSetPoint_withRegressionAfterCalibration.png

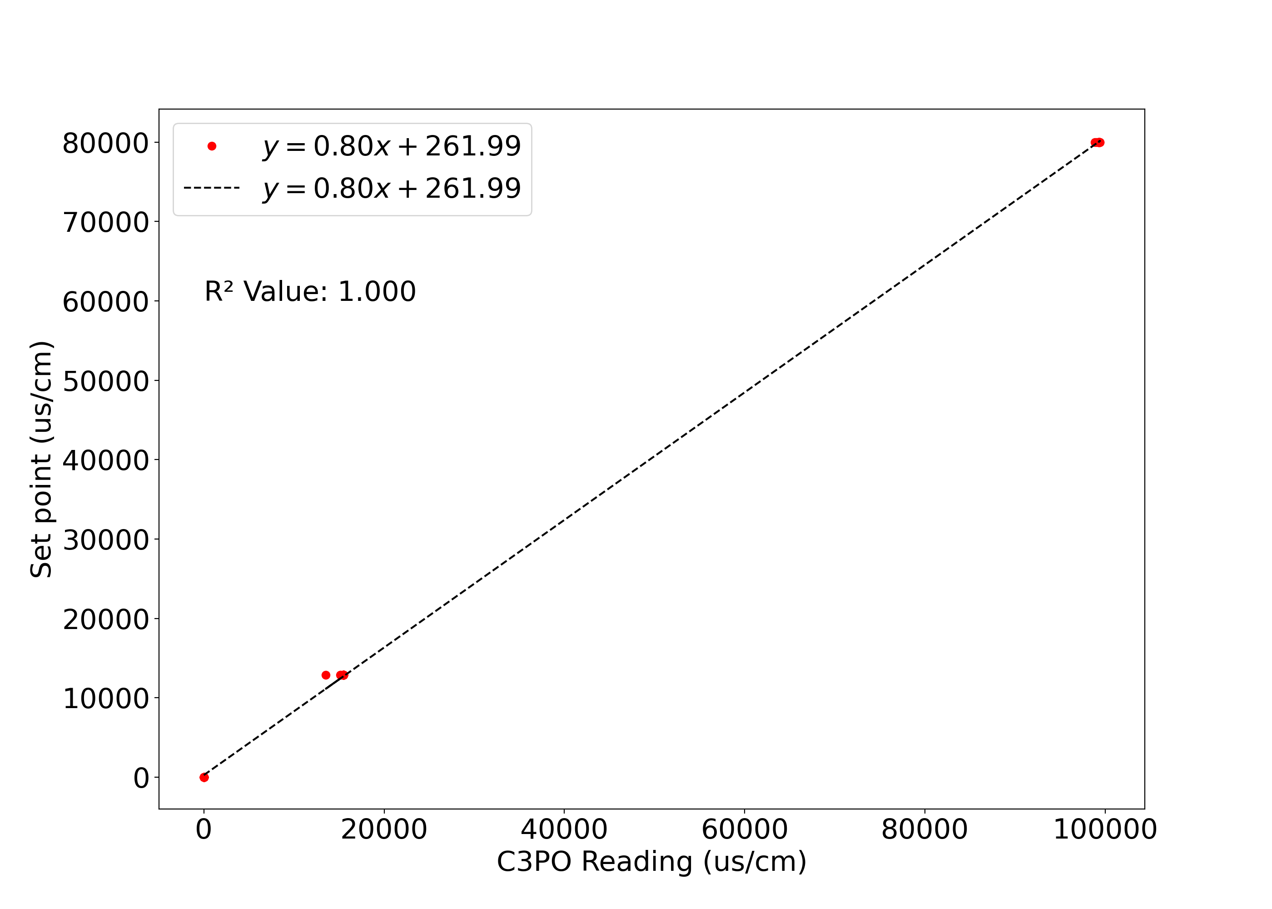
Calibrations/C3PO_1/2025_04_23_Calibration/Figures/C3PO_1vsSetPoint_withRegressionAfterCalibration.png
