COAST-Lab/c3po/Calibrations/C3PO_2/2025_12_22_Calibration/Figures/C3PO_2PreandPostCalibration.png

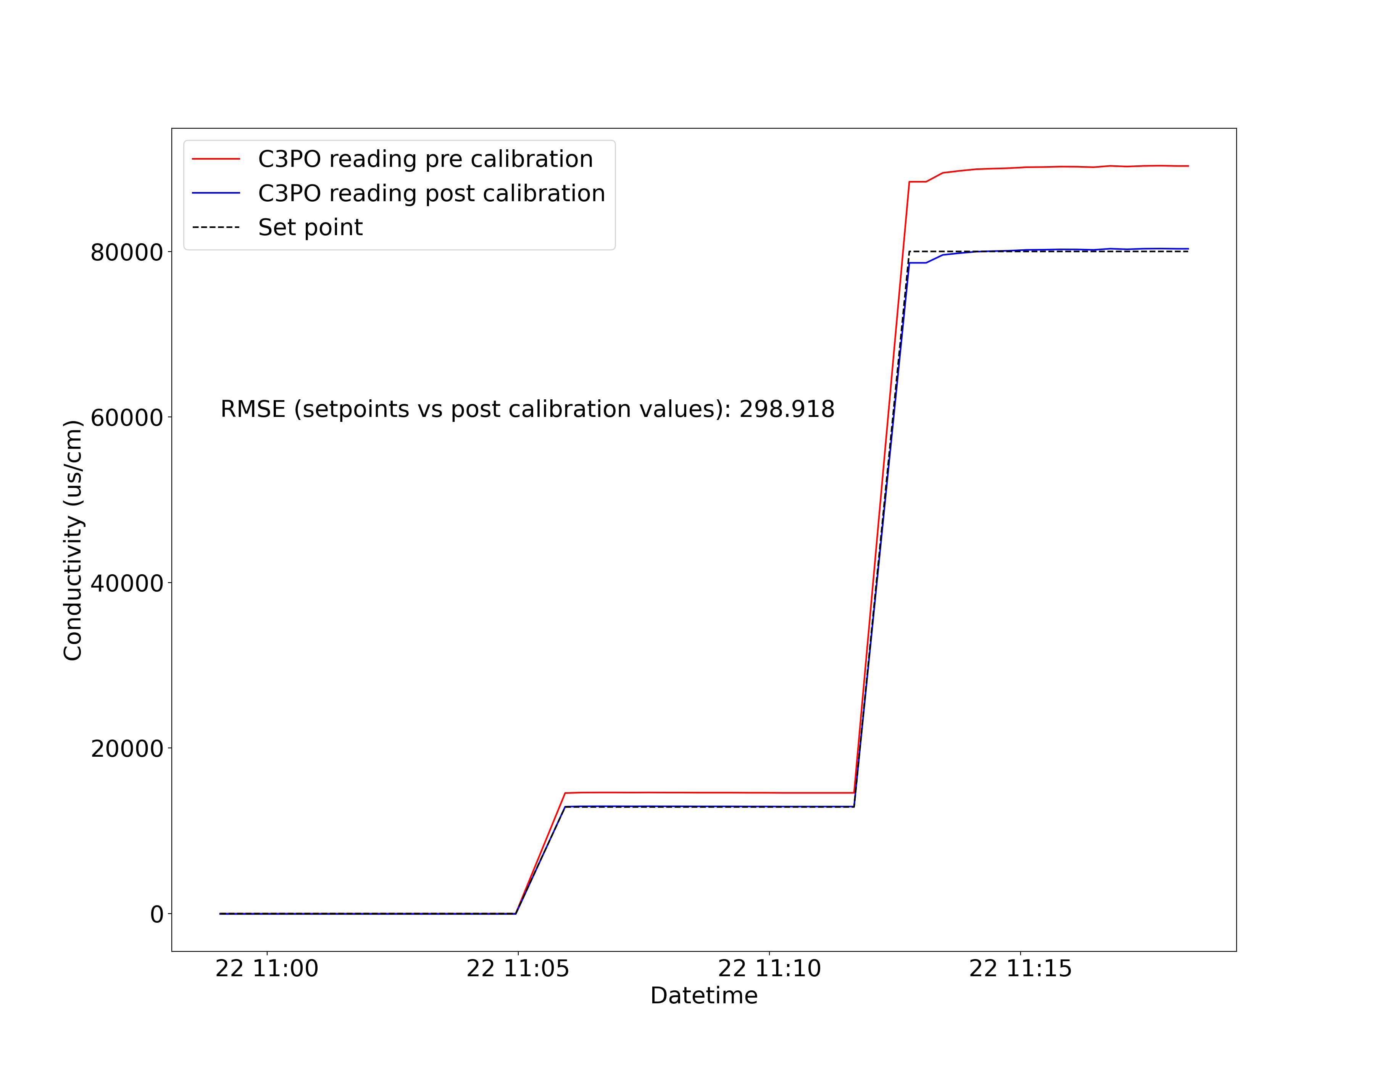
Calibrations/C3PO_2/2025_12_22_Calibration/Figures/C3PO_2PreandPostCalibration.png
