COAST-Lab/c3po/Calibrations/C3PO_2/2026_07_22_ReCalibration/Figures/C3PO_2PreandPostCalibrationwithCalibration.png

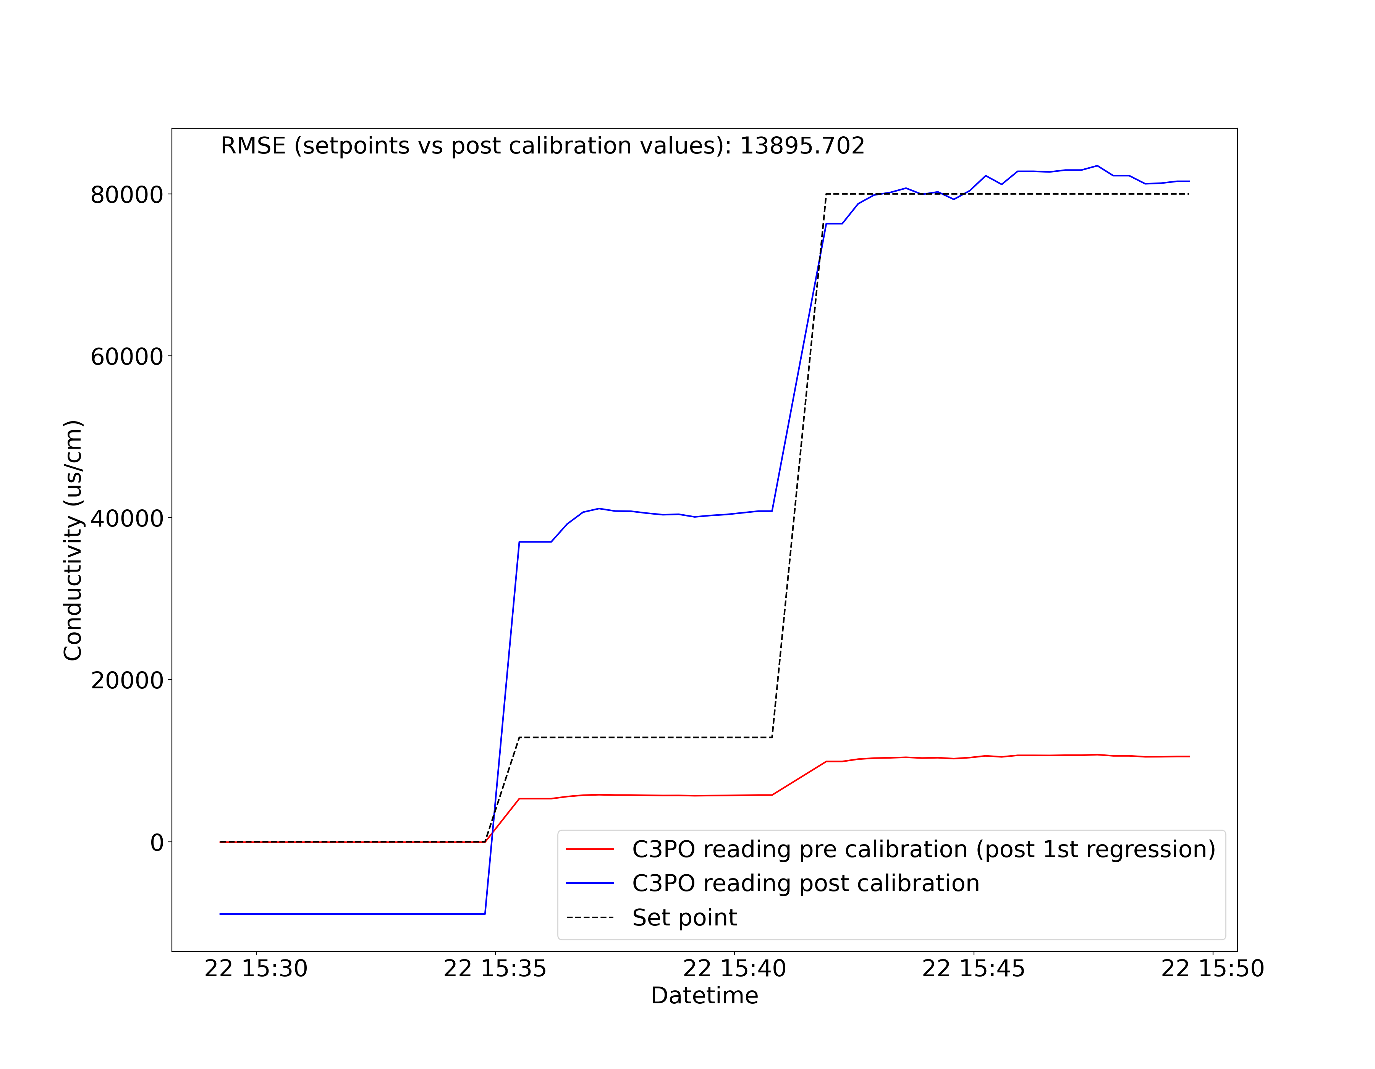
Calibrations/C3PO_2/2026_07_22_ReCalibration/Figures/C3PO_2PreandPostCalibrationwithCalibration.png
