COAST-Lab/c3po/Calibrations/C3PO_3/2025_12_22_Calibration/Figures/C3PO_3PreandPostCalibration.png

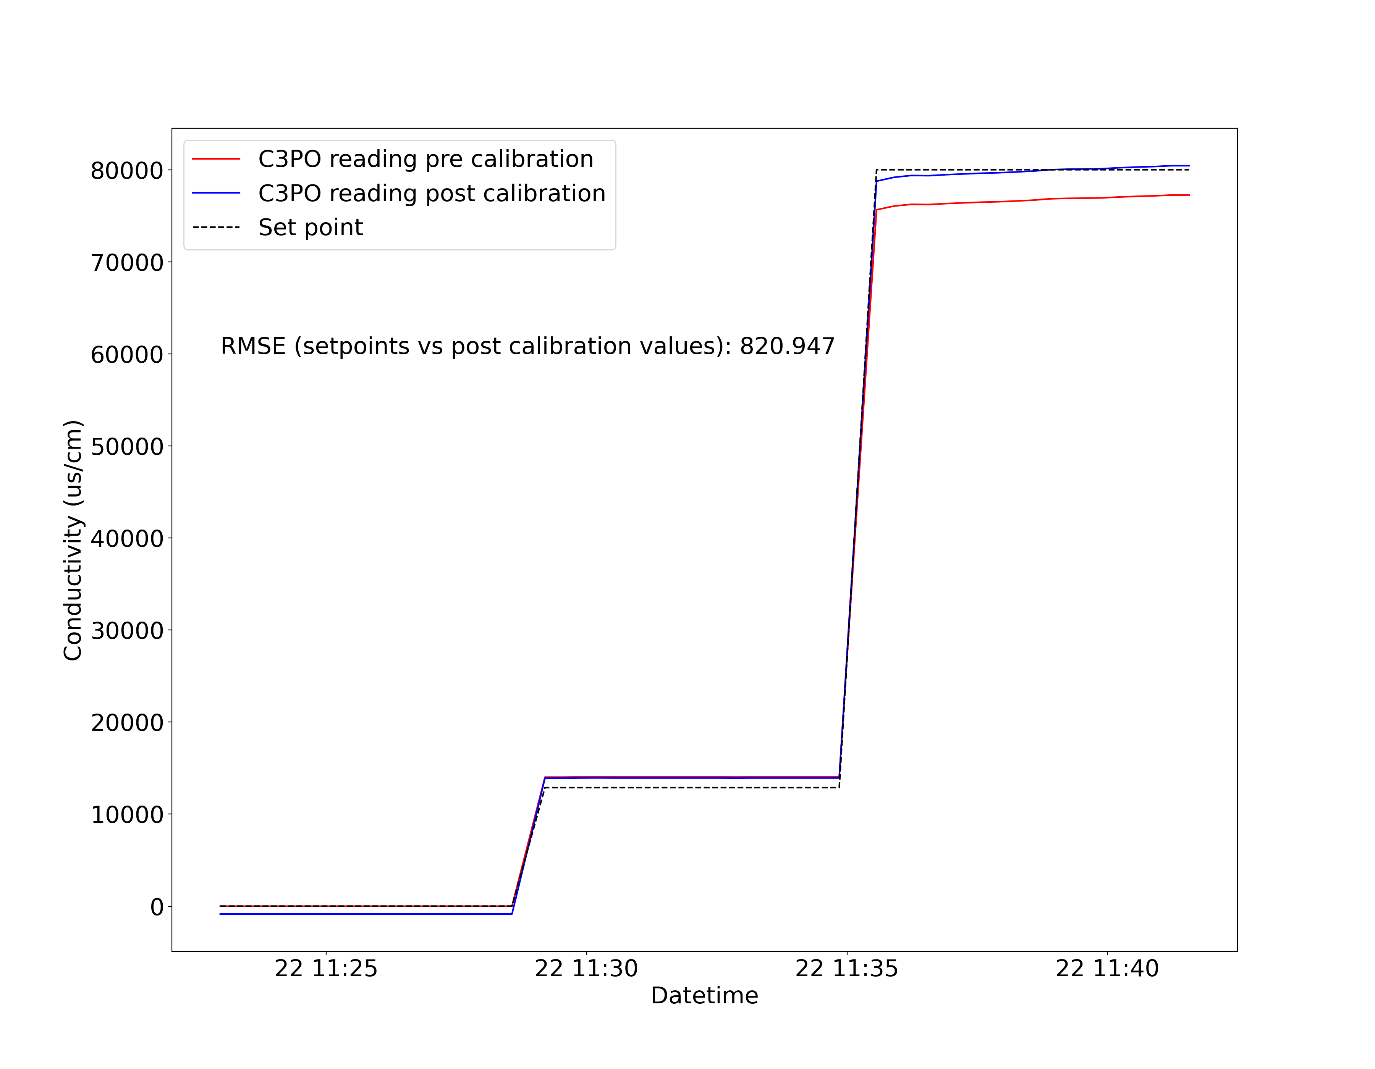
Calibrations/C3PO_3/2025_12_22_Calibration/Figures/C3PO_3PreandPostCalibration.png
