COAST-Lab/c3po/Calibrations/C3PO_3/2026_07_22_ReCalibration/Figures/C3PO_3PreandPostCalibrationwithCalibration.png

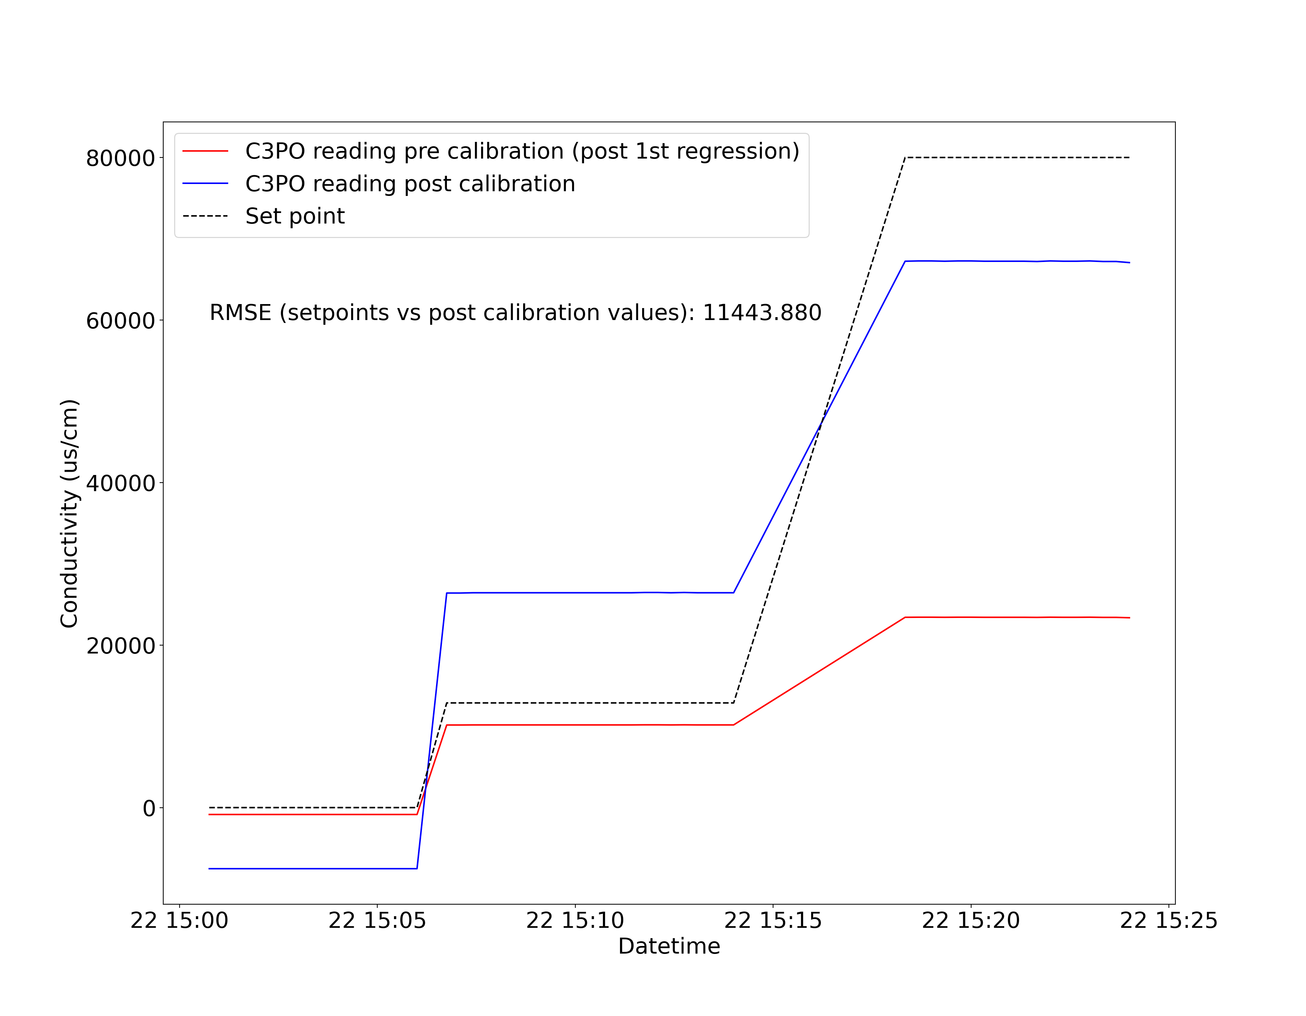
Calibrations/C3PO_3/2026_07_22_ReCalibration/Figures/C3PO_3PreandPostCalibrationwithCalibration.png
