COAST-Lab/c3po/Calibrations/C3PO_4/2026_07_22_ReCalibration/Figures/C3PO_4PreandPostCalibration.png

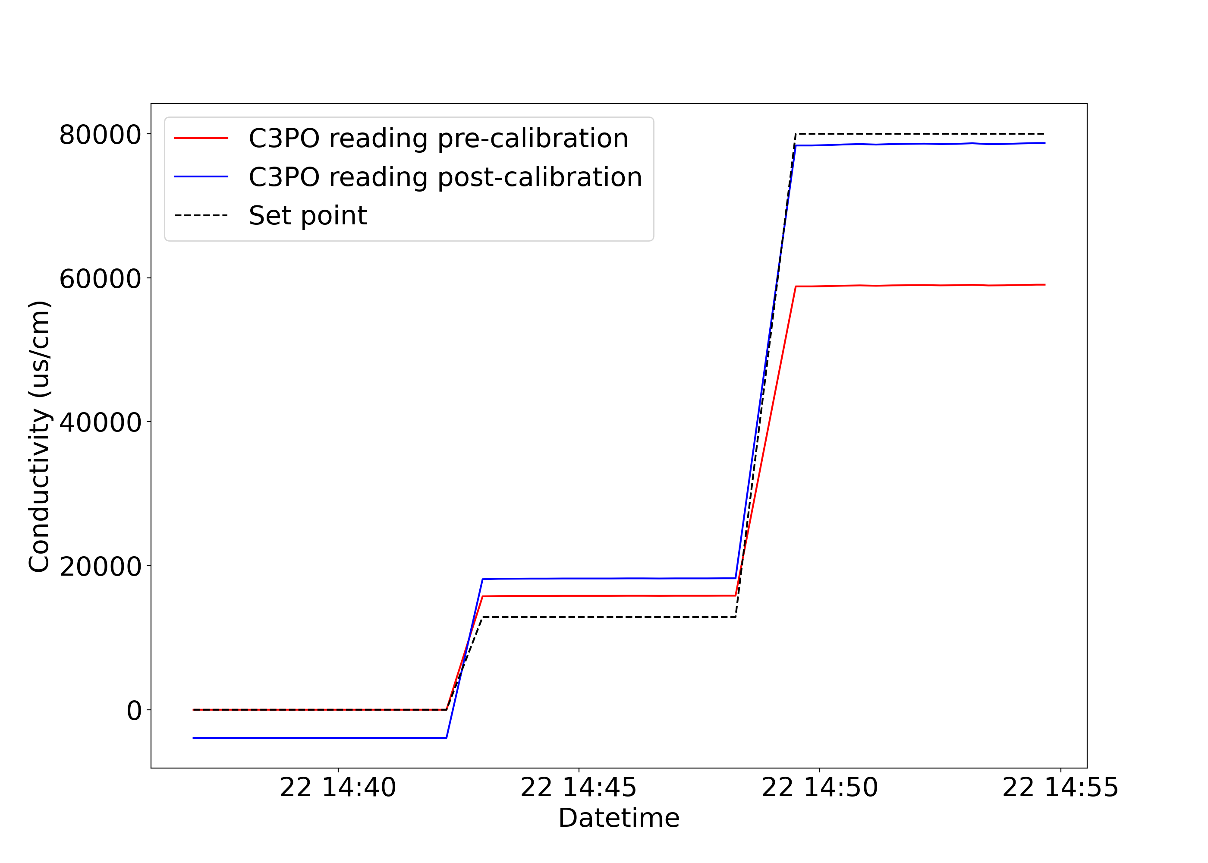
Calibrations/C3PO_4/2026_07_22_ReCalibration/Figures/C3PO_4PreandPostCalibration.png
