COAST-Lab/c3po/Calibrations/C3PO_5/2025_12_22_Calibration/Figures/C3PO_5RawReadings.png

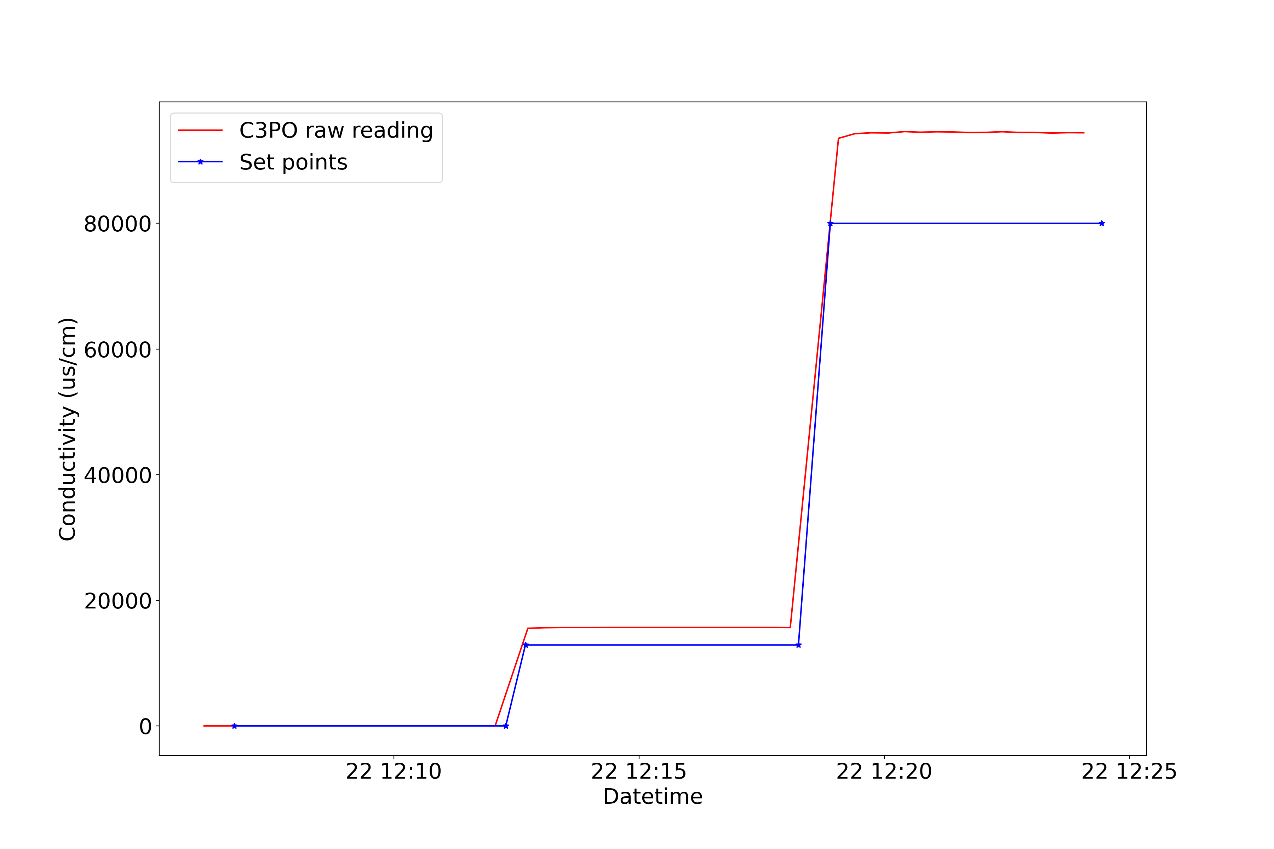
Calibrations/C3PO_5/2025_12_22_Calibration/Figures/C3PO_5RawReadings.png
