COAST-Lab/c3po/Calibrations/C3PO_5/2026_07_22_ReCalibration/Figures/C3PO_5PreandPostCalibrationwithCalibration.png

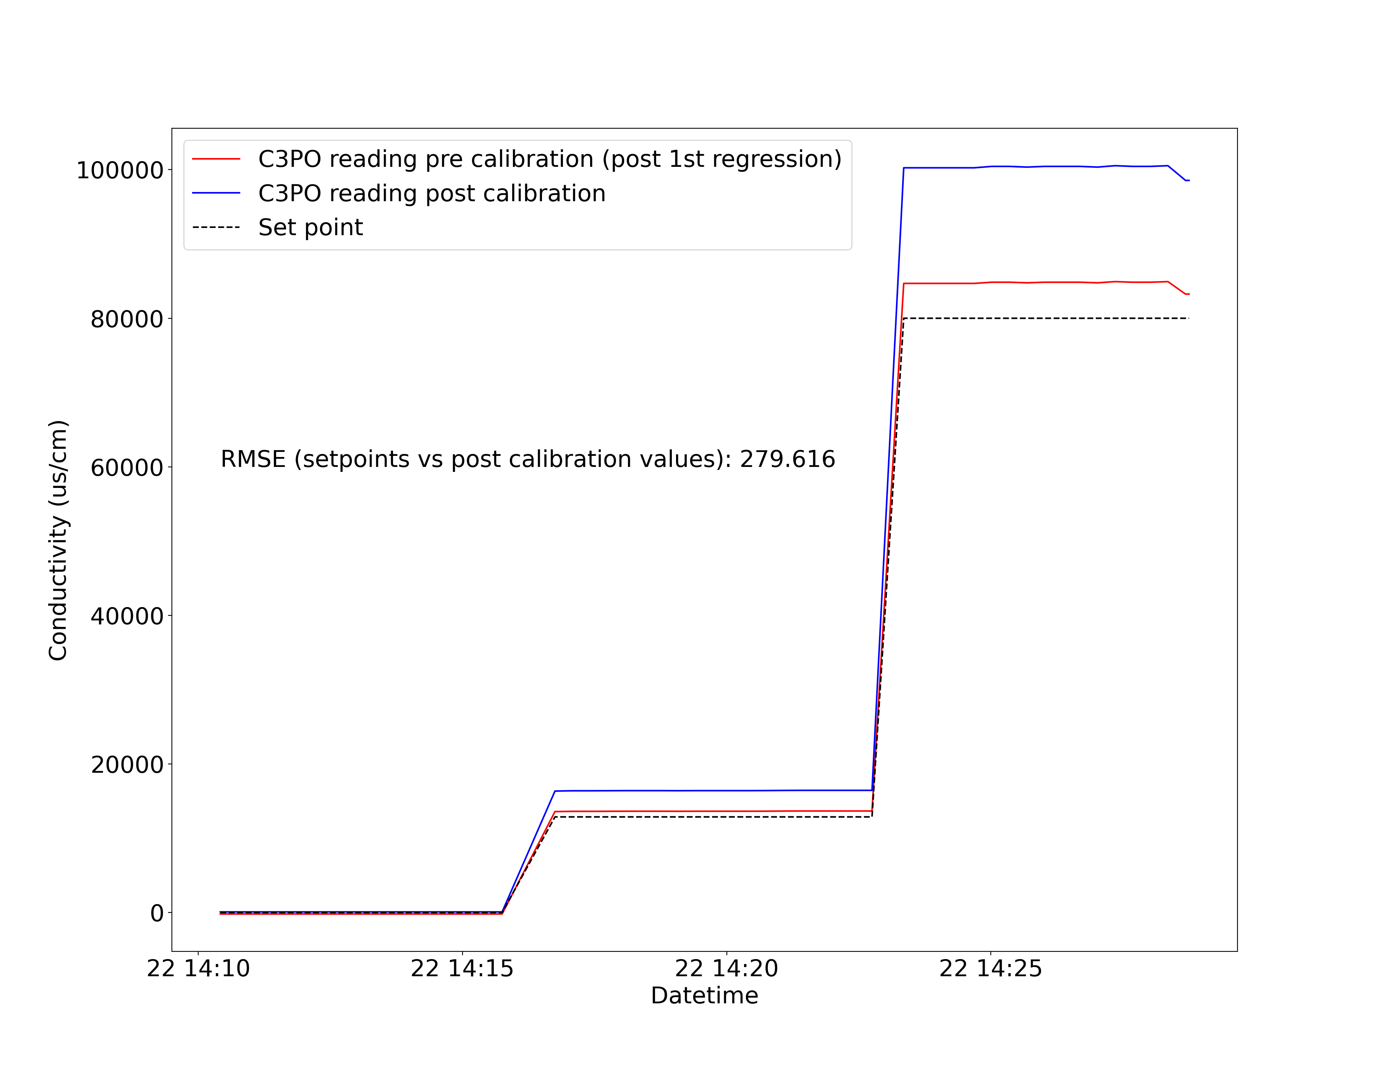
Calibrations/C3PO_5/2026_07_22_ReCalibration/Figures/C3PO_5PreandPostCalibrationwithCalibration.png
