COAST-Lab/c3po/Calibrations/C3PO_6/2026_07_22_Calibration/Figures/C3PO_6RawReadings.png

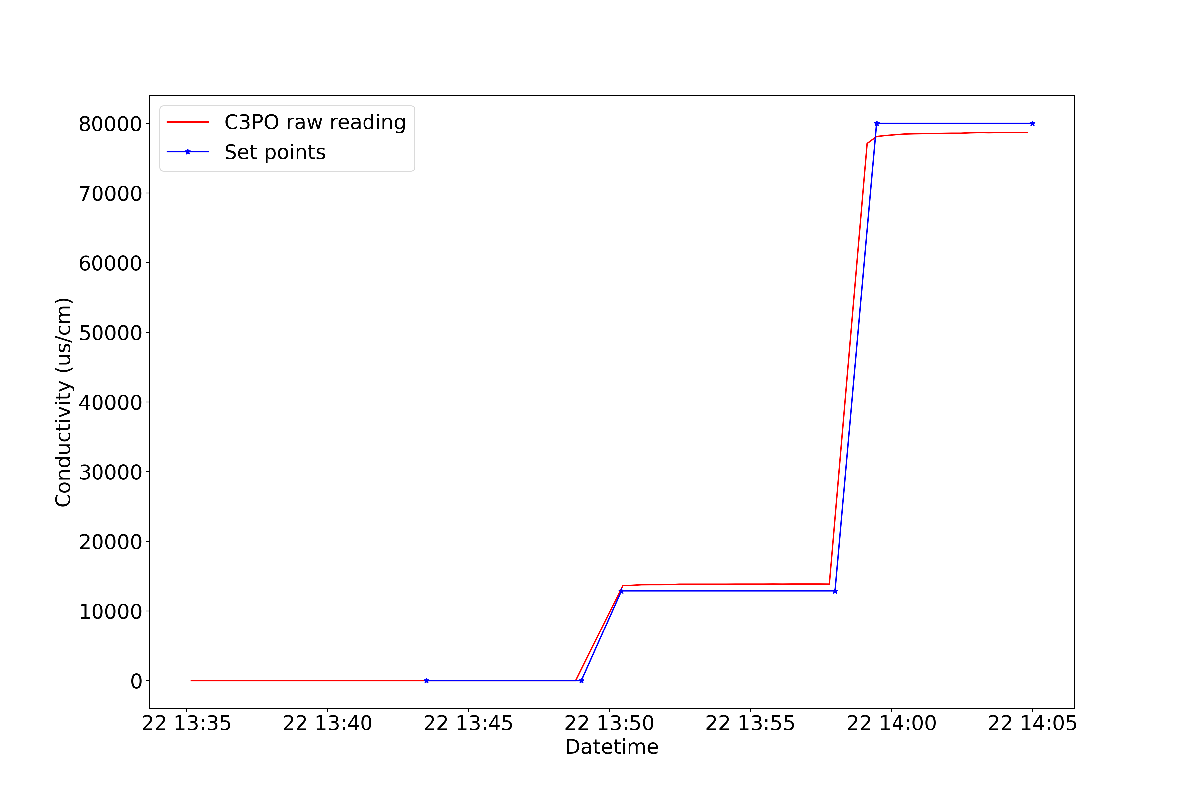
Calibrations/C3PO_6/2026_07_22_Calibration/Figures/C3PO_6RawReadings.png
