COAST-Lab/c3po/(threads)

Thread 8 (2024-06-25):

Collect data from salinity probe

BentleySettin, 2024-06-25:

gracelower, 2024-07-23:
When compiling the current code, I am met with the following errors:
- `Ezo_board(uint8_t address);  //Takes I2C address of the device` --- error: explicit type is missing ('int' assumed), error: expected constructor, destructor, or type conversion before ';'
- `Ezo_board(uint8_t address, const char* name); //Takes I2C address of the device //as well a name of your choice` --- error: explicit type is missing ('int' assumed), error: expected constructor, destructor, or type conversion before ';'
- exits with error code 2

Possible sources of these errors may be incorrect declaration of classes or functions (i.e. where a constructor, destructor, or type conversion is expected, another entity is coded instead).

Possible solutions to this problem may include accurately declaring / defining classes, member functions, or constructors / destructors, or denoting enums properly.

gracelower, 2024-07-25:
Solutions to this issue + the updated (compiled, flashed, tested w/ probe) code can be found in pull request https://github.com/TinyCamML/ConductivitySensor/pull/14 (7/24/24)

See this [comment](https://github.com/TinyCamML/ConductivitySensor/pull/14#issuecomment-2250181493) for confirmation (7/25/24)

Closed 2024-07-25.

Thread 12 (2024-07-18):

Documentation

gracelower, 2024-07-18:
Opening this issue as an ongoing task to expand documentation for the Conductivity Sensor --

As this project progresses, I think there are lots of areas that could use more detailed documentation, such as:
- instructions for the device assembly process
- photos of parts & assembly
- more detailed BOM / parts list
- explanation about goal(s) of this project, next steps, etc.

gracelower, 2024-07-22:
[pull/13#issue-2423218623](https://github.com/TinyCamML/ConductivitySensor/pull/13#issue-2423218623)

Closed 2024-09-11.

Thread 25 (2024-09-27):

Confirm sensor sleep commands

SUPScientist, 2024-09-27:
Current sensor sleep commands:

https://github.com/COAST-Lab/ConductivitySensor_Old/blob/42f6ad3f61daf9208db27fdebbddd982a49db844/Firmware/AtlasConductivity_20240724/src/AtlasConductivity_20240724.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

Doubtful this works as intended. Confirm with (1) datasheet and (2) power monitoring during usage. Much likelier to be a call to the `EC` and `RTD` objects than a text-based I2C command.

gracelower, 2025-02-04:
@efarq added some sleep commands / delays on 20 December 2025, which are now reflected in the .cpp code file; these delays allowed the Boron and EZO circuits to interact cooperatively

SUPScientist, 2025-02-04:
Note that even if those commands work as described/intended (questionable), 0.5 mA is still too high for sleep current, so we'll need to add a solution to further reduce power draw, such as a FET switch (like in TinyCamML).

gracelower, 2025-02-04:
Good to know, thanks for clarification. Will definitely investigate this / keep an eye on it as we move forward.

efarq, 2025-07-30:
I think with the updated source code I made in commit #ea04c91 , this is no longer an issue, as I do not use the EC.send_cmd("sleep") function at all. However, I will still try to use a multimeter to assess the power draw during the different stages to ensure.

Thread 26 (2024-09-27):

Check sig figs in data string

SUPScientist, 2024-09-27:
In

https://github.com/COAST-Lab/ConductivitySensor_Old/blob/42f6ad3f61daf9208db27fdebbddd982a49db844/Firmware/AtlasConductivity_20240724/src/AtlasConductivity_20240724.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

it appears that different numbers of digits are reported from the temp vs. cond sensor. Check to see how many the sensor reports and record/transmit all.

gracelower, 2024-10-07:
Line 153 snprintf(data, sizeof(data), "%li,%.5f,%.02f",
Line 154 real_time, // if it takes a while to connect, this time could be offset from sensor recording
Line 155 temp,
Line 156 cond

format specifiers `%.5f and %.02f` control how many digits are shown after the decimal point for floating-point values (temp and cond)
- .5f = five digits after decimal point
- .02f = two digits after decimal point

––> Adjust specifiers based on what sensors report so we receive same number of digits for cond + temp sensors

gracelower, 2024-11-01:
Attempting to update code / fix this issue, but returning this error when trying to install SdFat library: "Access token provided is invalid"

https://api.particle.io/v1/libraries/SdFat?version=latest

Is SdFat no longer available? Or is my software not compatible / do I need to update something?

SUPScientist, 2024-11-01:
That's a particle login issue most likely. Check that you're logged into your particle account in VS Code

efarq, 2025-07-30:
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

The current format for the temp/conductivity data points is 0.2f, or 2 places after the decimal. I've attached two images from the publishing spreadsheet that show that during low conductivity readings, it reports values to the hundredths place; however, during high conductivity readings, it does not report any values to in the hundredths place.

Additionally, it sounds like we could go to 0.3f for the RTD sensor, but I don't necessarily think we need to? And the 0.2f seems sufficient for the conductivity, but I would be glad to hear any one else's opinion.

SUPScientist, 2025-07-31:
Thanks for following up on this.

It appears that cond is reporting 4 sigfigs, so I think the 0.2f is fine (though it's nowhere close to accurate to a single µS/cm, so if it reports, for example, 12.51 µS/cm, we wouldn't trust it at better than ~ 10).

For temp, if it reports 3 decimal places, might as well save 'em and we can figure out how to post-process with that level of resolution after the fact. It doesn't cost us anything since we're nowhere close to max publish message length.

Thread 27 (2024-10-04):

Check possible I2C interference

gracelower, 2024-10-04:
"I2C signal wires that run to sensor from electronics board are subject to interference from one another. When wires run immediately next to one another, we get data failures; when they are physically separated, the data are fine." --> Crosstalk issues; need to see if this issue arises in C3PO

SUPScientist, 2024-10-04:
Observed problem, or forecasted one? Not a bad idea to catalog potential pitfalls, but I don't anticipate this being a major issue for us. We'll only have one set of I2C wires from the controller package to the sensor package, and then, from there, the different addresses of the different I2C chips in the sensor package will handle parsing out data between sensors. Unless you've seen this in practice, keep in a very low priority category (in my estimation)!

Closed 2025-07-30.

Thread 28 (2024-10-07):

Develop sensor housing

gracelower, 2024-10-07:
To-do: Design & build an enclosure for upper and lower portions of prototype.

Upper –
Must house electronic components, wires, internal chassis for electronics
Must be waterproof to protect electronics (cable glands for cable entry?)
Attaches w/ solar panel to upper signpost to avoid floodwaters + maintain solar energy access
--> Polycase enclosure

Lower –
Must house temp & conductivity probes
Internal chassis to hold probes?
Attaches to lower portion of signpost so sensors can reach floodwaters
--> PVC pipe enclosure

gracelower, 2024-11-27:
https://github.com/gracelower/Open-Water-Level/blob/5f59bb985436eb970dc5fbef83e0cc34b8c69727/Fabrication/Polycase-Enclosure/Enclosure-and-Assembly/Chassis_Polycase_2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

This is the type of chassis I'm considering for the Polycase housing based on what we brainstormed. Has a space for the cellular antenna and has slots for Adalogger FeatherWing pins (stacked under Boron 404x).

Uses same materials (screws, Polycase) as Open Water Level, which are sourced here: https://github.com/gracelower/Open-Water-Level/tree/5f59bb985436eb970dc5fbef83e0cc34b8c69727/Fabrication/Polycase-Enclosure/BOM

Something to consider though: using a different Polycase with knockouts for cable glands (for solar + waterproof 4-wire cables), like this https://www.polycase.com/sk-12 (would have different chassis dimensions, but similar chassis concept)

gracelower, 2024-12-16:
Current status of enclosures:

**Upper body**
- Polycase [SK-15](https://www.polycase.com/sk-15) w/ knockouts + clear lid (note: switch to a model with a flip lid?)
- Basing chassis design on [SK-15K](https://www.polycase.com/sk-15k) mounting panel dimensions
- Cellular antenna frame
- Slots for header pins + holes for Boron/FeatherWing mounting screws
- Similar design concept to Water Level Sensor chassis

**Lower body**
- Sch 40 3" nominal PVC pipe
- Flat chassis that slides in/out of PVC by connecting to pipe cap (maybe via marine epoxy? meshed 3D print design?)
- Cable gland for 4-wire cable in pipe cap (3D printing?)
- Slots for Tentacle T3 Shield (same dimensions as i3 Interlink - new model) pins
- Holes for Tentacle T3 Shield mounting screws
- Connect temp + cond probes by U-clips?

gracelower, 2024-12-17:
This issue is now being addressed in #35 (Upper body housing) and #36 (Lower body housing) for more streamlined documentation of the separate body designs.

Thread 29 (2024-10-31):

UART --> I2C

gracelower, 2024-10-31:
Have spent much time attempting to switch EZO RTD circuit from UART to I2C mode based on the documentation provided, but:
- RTD will only blink cyan/green (UART mode); pictured below
https://www.whiteboxes.ch/docs/tentacle/t2-mkII/#/protocols

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

Was able to get EZO EC circuit to blink dark blue (I2C) after many attempts; pictured below.

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

SUPScientist, 2024-11-01:
I don't think this will fix your problem with the Atlas EZO circuit, but to at least eliminate one variable, I recommend flashing a blink LED script to your Boron with cell disabled. E.g., this one: https://github.com/SUPScientist/Smart-Coasts/blob/main/Class-01-Intro/Blink_LED.cpp. This might resolve the issue @efarq was describing re: Particle wanting you to claim the Boron, which I don't think should be necessary yet as long as you use `SYSTEM_MODE(SEMI_AUTOMATIC);`.

SUPScientist, 2024-11-01:
Next, could you confirm which documentation you are following to put the device into I2C mode? Is it https://files.atlas-scientific.com/EZO_RTD_Datasheet.pdf?

gracelower, 2024-11-01:
> Next, could you confirm which documentation you are following to put the device into I2C mode? Is it https://files.atlas-scientific.com/EZO_RTD_Datasheet.pdf?

Yes, that is the protocol I have been using, also described here: https://www.whiteboxes.ch/docs/tentacle/t2-mkII/#/protocols

I just worked through these steps again and seem to still only receive cyan/green blinking on the RTD. The EC switched to I2C properly (dark blue).

SUPScientist, 2024-11-01:
My questions are probably unhelpful because I know you're really thorough, but since I can't exactly see what pins you have connected to which, can you confirm that this is exactly what you're doing:
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

Idea 2: use the Boron's 3V3 as your power to the VCC port on the EZO board.

Idea 3: if that still doesn't work, you could also try to send a command via UART (hook up the Boron's 3V3 and GND to the RTD EZO's VCC and GND and then the Boron's Rx to the EZO's Tx and vice versa). Then put a line in your `void loop()` function that is, I think, `Serial1.println('I2C,100');` Note that it will then use 100 as the address if it works. You also have to reboot it (disconnect/reconnect power to EZO) to see if new color appears to indicate I2C mode.

gracelower, 2024-11-01:
Update:
Was able to get RTD to cyan/aqua blinking --> indicates I2C communication
EC is still showing solid blue --> indicates UART connection
When powering from Boron's 3V3 instead of VUSB, I am able to get a solid green, which I think indicates standby mode, though does not indicate whether it's in I2C or UART.
Will try Idea 3 soon! Thanks for the assistance!

gracelower, 2024-11-07:
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

Closed 2024-11-07.

Thread 31 (2024-11-11):

Ezo_i2c libraries "nonexistent"

gracelower, 2024-11-11:
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

Ezo_i2c, Ezo_i2c.h, other variations of this library "do not exist" when I try to install them; above are screenshots from compiling code without library
I am logged in through my Particle account, so that's likely not the issue (?)
- That was the issue for the SdFat library

Potential causes:
- I am incorrectly trying to install a library
- I have an incorrect setting in my file pathway

SUPScientist, 2024-11-12:
Weird. Must be a workflow issue or similar. I just cloned the entire repo, opened the c3po/Firmware/AtlasConductivity_20240724 folder in VS Code/Workbench, compiled without touching anything, and it worked fine.

A few thoughts...
- The libraries for the ezo stuff are already in /lib, so you don't need to manually install anything.
- Are you opening only the Particle project (c3po/Firmware/AtlasConductivity_20240724) in VS Code or the whole repo (should be the former)?
- Anything else will probably take more troubleshooting. I might be able to do a quick zoom tomorrow (Tues) if you want to give that a shot and share your screen to show me what you're seeing. I'm at NC Coastal Conf Wed and then back Thu.

gracelower, 2024-11-12:
I figured it was likely a pathway issue on my end. Unfortunately, my schedule is pretty packed today, but I'll investigate this deeper tomorrow morning. Thanks!

gracelower, 2024-11-15:
I removed my cloned repo and started over by cloning the c3po repo again and opening the whole repo in VS Code, which eliminated the pathway error of accessing the Ezo library. However, I'm now receiving errors claiming that a couple of files actually within the i2c library can't be accessed, so I'm going to reboot this process to try again. I think my issues are all stemming from pathway problems, so I'm going to approach cloning very deliberately.

gracelower, 2024-11-15:
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

These are the errors I'm receiving, even after I started from scratch with a new cloned repo. It appears that the files `I2Cdev.h` and `MPU6050.h` can't be accessed or don't exist, though they are called by
`#include "I2Cdev.h" #include "MPU6050.h"` at the beginning of the src file.

SUPScientist, 2024-11-15:
This looks like the problem described in email by @BentleySettin: "One VS issue I ran into before was opening the entire GH repo and not just the designated project folder in VS. Opening the entire repo led to many issues such as with libraries."

The solution is to open only the Particle project (c3po/Firmware/AtlasConductivity_20240724) in VS Code. That is, navigate to AtlasConductivity_20240724 when opening the project, not the whole repo. The left-hand side shows that you have the whole repo open.

gracelower, 2024-11-15:
I may have found my issue -- I had tried what @BentleySettin suggested (opening solely the Particle project) and I received the same error, so I retraced my steps & realized I had been manually setting the device & OS to "Boron" & "4.2.0" like we did in the summer for the water level sensor. I then tried setting to "Boron" and "6.1.1" which was the given OS when opening just the Particle project (and was then given the ability to "clean" the "dirty" file) and compiled successfully. Are we using OS 6.1.1 for these sensors moving forward?

SUPScientist, 2024-11-15:
Glad it works! I'm DeviceOS agnostic—whatever works is fine for now. But sticking with something relatively up to date like 6.1.1 does sound wise. When you open at the Particle Project level, it should automatically know what version had been used because that comes along in one of the settings files (I always forget which). But it sounds like this is solved, so nice work! I'll let you close if that's correct.

Closed 2024-11-15.

Thread 32 (2024-11-28):

Test code w/ sensors

gracelower, 2024-11-28:
Code ([Firmware/AtlasConductivity_20240724](https://github.com/COAST-Lab/c3po/tree/ce125387664c0b1ae50e006cd57f2a87b746afdf/Firmware/AtlasConductivity_20240724)) compiles and flashes properly when using Boron 6.1.1 device & OS. However, when opening the serial monitor, it is blank (i.e. `Serial monitor opened successfully` and nothing else).

I have tried:
- following the set-up instructions as written here: https://github.com/gracelower/c3po/blob/main/Documentation/SetUp.md
- following this pinout: https://files.atlas-scientific.com/i3-interlink-datasheet.pdf (page 5)
- changing `SECONDS_BETWEEN_MEASUREMENTS = 360` to `60` for testing

gracelower, 2024-12-13:
Tried with only EZO EC circuit, Atlas Isolated Carrier Board, EZO EC probe, and Boron / Adalogger.
Wired VCC / 3V3, GND / GND, SDA / SDA, SCL / SCL.
Still receiving blank serial monitor.

EZO EC is correctly showing dark blue LED which is I2C.
Boron blinks green, which on Particle website, is indicated as "connecting to network." Could this be a source of error? I would think the device would still be recording internally on the microSD card even if no network connection exists, though Dr. Hino said we do not have a microSD card in Chapel Hill, so I haven't been able to check if it has been storing data.

gracelower, 2024-12-16:
The Boron has been claimed via the Particle app (special thanks to @efarq for help with that!)
I will go back to `PUBLISHING 0` now and see if that makes any adjustments to the LED status!

gracelower, 2024-12-16:
Updates:
- I have tried `PUBLISHING 0` and unfortunately am only getting the device to blink green; I will read Particle forum posts to see if anyone in the "Particle-verse" has experienced this issue
- Maybe I can manually turn off the network connection through the Particle Console / app?
- Found a converter at my house; no files on microSD card (expected, since sensor is being blocked)

SUPScientist, 2024-12-16:
Have you gone through the getting started steps that you used (and for that matter helped write!) for the open-water-level sensor (https://github.com/COAST-Lab/Open-Water-Level/blob/main/Firmware/Getting_Started%20with%20Cell-Enabled%20Water%20Level%20Sensing.md)? For instance, have you confirmed that the Boron is running the same Device OS that you are compiling for (it looks from the following to be 6.1.1):
https://github.com/COAST-Lab/c3po/blob/ce125387664c0b1ae50e006cd57f2a87b746afdf/Firmware/AtlasConductivity_20240724/.vscode/settings.json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

My next advice would be to take a giant step back and confirm that you can get the Boron to do anything that you want it to do, such as blink an LED. If you can strip away any unnecessary complexity to see what is and isn't working and then build it back up, that will help identify the source of the problem(s).

gracelower, 2024-12-19:
In reference to: https://github.com/COAST-Lab/c3po/issues/34#issuecomment-2555770926

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

gracelower, 2024-12-20:
Pictured is an example of output after ...
- wiring Boron / Adalogger to Port 4 on Tentacle T3 Shield instead of upper rows of pins
- reformatting microSD card
- adding delays to code to account for sleep timing & serial connections

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

Closed 2024-12-20.

Thread 34 (2024-12-17):

(Re)gain control of Boron

SUPScientist, 2024-12-17:
### Problem
As described in https://github.com/COAST-Lab/c3po/issues/32, the Boron does not seem to be responding to any flashed code. Instead, regardless of whether cell is on or off, the status LED continues to blink green. @gracelower has confirmed that it has been device restored to Device OS 6.1.1 and that code is being compiled on Device OS 6.1.1. Workbench successfully compiles code and Boron appears to indicate successful flashing, but then Boron goes back to blinking green and does not execute flashed code.

### Recommended troubleshooting
Try the device doctor: https://docs.particle.io/tools/doctor/. I haven't used this yet myself but it is recommended in several threads pertaining to issues with Borons incessantly blinking green.

@efarq tagging you to notify you of this new issue.

SUPScientist, 2024-12-17:
OK, I don't know the source of the problem yet, but I uncovered a major clue when trying to reproduce @gracelower's issue. I reproduced it simply by cloning this repo, compiling, and flashing the firmware onto a new Boron using Device OS 6.1.1 (as has been used in this repo. I did a bunch of stuff to try to ascertain what was wrong and, without getting into all those details, what I learned was that I had to go back to the Open-Water-Level's Device OS version (4.2.0) to get the Boron to respond as expected.

This suggests that somewhere between Device OS 4.2.0 and 6.1.1, Particle changed something in either `SYSTEM_MODE(SEMI_AUTOMATIC)`, `Cellular.off()`, and/or `Particle.connect()` most likely. I'll keep digging.

One apparent workaround to test the sensors would be to keep `#define PUBLISHING 0` and do a device restore USB to 4.2.0 and switch the Device OS version to 4.2.0 in VS Code/Workbench. Not an elegant final solution but worth testing.

SUPScientist, 2024-12-17:
Trying to learn more here: https://community.particle.io/t/new-ish-behavior-with-system-mode-semi-automatic-and-manual/68799.

gracelower, 2024-12-18:
Aha! Great catch! I also just replicated the Blink_LED process using 4.2.0 instead of 6.1.1 and was able to get the Boron to breathe a white LED instead of blink green.
Working on flashing the cond/temp code to the device now and seeing if any results appear in the serial monitor.

SUPScientist, 2024-12-18:
@efarq and @gracelower please read the community thread that I linked three posts ago in this issue before Friday (and, if possible, test on your system, Grace). Specifically that last part about running `particle update` in the Particle CLI which appears to help download/install the missing dependency. I'm confused (as I noted in the thread) as to why the Device Restore USB tool doesn't do this, but at least we know more about how these devices work now.

I can now confirm that my Boron behaves as expected running Device OS 6.1.1 and the current firmware (https://github.com/COAST-Lab/c3po/commit/76d3c5f8d662edbfc362859a7f6788e4f9936ec2) so I'm closing this issue and we can return to troubleshooting the sensors themselves.

gracelower, 2024-12-19:
I am confirming that by using the `particle update` and `particle serial inspect` commands as detailed in your forum discussion, I am able to successfully compile and flash Blink_LED code to the Boron using OS 6.1.1, resulting in it breathing white instead of breathing green. I am also able to successfully flash the AtlasCond code to the Boron under OS 6.1.1, but then lose the LED altogether. I have deduced that this is not a physical power / connection issue because I am still able to see LED signals when interacting with the Mode and Reset buttons (on the Boron), so I am wondering if this may have to do with sleep commands; perhaps the Boron is going to sleep after flashing due to commands in the AtlasCond code? For reference, I have `PUBLISHING = 0` and have not changed the `SECONDS_BETWEEN_MEASUREMENTS` from 360. This might be worth investigating in person tomorrow (Friday 12/19).
https://docs.particle.io/troubleshooting/led/

SUPScientist, 2024-12-19:
Wonderful! Thanks for the update. I think we can fully move out of this thread now as this issue seems to be resolved.

Yes, I'd put lots of $$$ on this being simply a matter of sleep timing. If you have the serial monitor open when you run the code (and have it configured to automatically reopen when connection is re-established), you should see it print to the monitor that it is going to sleep. I saw the same behavior yesterday. I believe it's doing exactly what it should be!

Closed 2024-12-18.

Thread 35 (2024-12-17):

Upper body housing

gracelower, 2024-12-17:

gracelower, 2025-01-23:
I had been designing a chassis based on the [SK-15K plate](https://www.polycase.com/sk-15k) for the [Polycase SK-15](https://www.polycase.com/sk-15) with clear lid, which I felt that of the enclosures with knockouts, had the best dimensions for the upper body (housing the Boron, Adalogger, & cellular antenna). However, it looks like the SK-15 just went out of stock for the forseeable future ... I have made some chassis sketches for the [SK-14](https://www.polycase.com/sk-14), though I'm not sure how a square Polycase may fasten to the solar panel bracket?

gracelower, 2025-03-28:
Upper body design specs can be found here: [Specs](https://docs.google.com/spreadsheets/d/1jwsCTRAA01V_unxgK_Tak2z3rraIz2d1vFaZZr05xrk/edit?usp=sharing)

3D print chassis based on Polycase SK-14K
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

gracelower, 2025-04-02:
.stl files for 3D designs have been added to the repo –
Commit: https://github.com/COAST-Lab/c3po/commit/97b56c0644a478266c53f73f97005d2dce2971e3

gracelower, 2025-04-26:
Thu Apr 24 2025
Polycase enclosing Boron & Adalogger, plus solar panel
See [this issue](https://github.com/COAST-Lab/c3po/issues/43) about mounting

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

Thread 36 (2024-12-17):

Lower body housing

gracelower, 2024-12-17:

gracelower, 2025-01-23:
I had been considering a 3D-printed cap for the PVC pipe that would have either a:
- larger hole for cable gland, through which 4-wire cable is threaded & therefore removable if needed
- smaller hole through which 4-wire cable is threaded & epoxied

I had also considered a purchasable flat-top pipe cap (example [here](https://www.mcmaster.com/2389K104/)) to which the 3D-printed chassis could be epoxied ... not sure if purchasing has any benefits over 3D printing this same design with the chassis already attached --> Should pipe cap lay flush with 3" nominal PVC, or cover it like a cap?

Could also use a rubber stopper + cable entry through PVC pipe itself, though would have to epoxy, not cable gland due to curvature of PVC pipe

SUPScientist, 2025-01-24:
@gracelower @efarq check out https://github.com/COAST-Lab/Open-Water-Level/blob/main/Fabrication/PVC-Enclosure/Enclosure-and-Assembly/PVC-End-Cap/PVCTop.stl for an example of a custom end-cap designed for sealing off one end of a 1.5" SCH 40 PVC pipe with a hole for a cable gland. It is designed so that the smaller diameter of this end-cap fits inside the PVC, then the lid sits on the top edge of the PVC. We'll likely add a little extra sealant after final assembly for additional peace of mind.

gracelower, 2025-02-04:
Notes from Bentley –

O-ring for water level:
https://www.mcmaster.com/9464K291/

Resources for O-ring designs:
https://ceetak.com/o-ring-calculator/
https://dichtomatik.com.mx/catalogos/diseno-de-alojamientos.pdf
https://www.globaloring.com/o-ring-groove-design/

Math for water level O-ring

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

gracelower, 2025-03-28:
@SUPScientist Thanks for the heads up. Will definitely keep that in mind as we proceed!

.stl files for 3D designs have been added to the repo –
Commit: 97b56c0644a478266c53f73f97005d2dce2971e3

gracelower, 2025-04-02:
Purchase order sent for:
- O-rings https://www.mcmaster.com/9464K734/
- Cable glands https://www.polycase.com/cg3-cable-glands#CG-32
- 3" nominal ID sch 40 PVC pipe
- Mounting screws for chassis

gracelower, 2025-04-21:
Notes from build days 4/17-18:

- 3D printed pipe caps are too big; need to decrease thickness of all aspects of .stl files for both upper and lower pipe caps (actual dimensions pictured below; measurements taken in person on 4/18)
- O-ring calculations did not provide us with a plausible O-ring design, so we found a better O-ring solution in the machine shop. need to find origin of new O-rings we were given so we can use those dimensions moving forward
- need to increase diameter of temp probe entry hole in .stl file (possibly was a printer issue though)
- need to source hose clamps for a future comprehensive DIY kit

gracelower, 2025-04-26:
PVC housing i3 Interlink & probes, attached to pole with hose clamps
Note: 3D-printed caps here had to be modified heavily post-print to accomodate O-rings and cable glands; thinner print designs are in progress

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

gracelower, 2025-05-05:
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

gracelower, 2025-05-08:
[BottomCap_NoGrooves_20250508.stl](https://github.com/gracelower/c3po/blob/main/Hardware/BottomCap_NoGrooves_20250508.stl)
[TopCap_NoGrooves_20250508.stl](https://github.com/gracelower/c3po/blob/main/Hardware/TopCap_NoGrooves_20250508.stl)

Thread 38 (2025-01-30):

Consider other circuitry for Atlas probes

SUPScientist, 2025-01-30:
### Problem
The interlink/tentacle shield is relatively large, forcing us to use a larger lower body housing, as described in https://github.com/COAST-Lab/c3po/issues/36.

### Potential Solution
The Atlas individual EZO (isolation) boards might suffice for our needs, e.g., the one used here: https://atlas-scientific.com/kits/conductivity-k-1-0-kit/ (isolated) and here: https://atlas-scientific.com/kits/sma-temperature-kit/ (non-isolated). Note that we wouldn't need new probes (temp or cond) nor EZO circuits, just the carrier boards. I believe that these carrier boards can use I2C just like the interlink/tentacle shield. One key difference is that we would need two different boards in this proposed scenario, but assuming they use I2C, the same 4 wires coming to the lower body housing from the upper body housing could be spliced/split off to those two carrier boards via separate wires. (This is effectively what the interlink/tentacle board does anyway, but via traces on a PCB rather than wires.)

The advantage here is huge space savings. Much easier to fit two of those carrier boards with their EZO circuits inside a little lower body housing.

@gracelower @efarq please review, consider this option, and provide feedback when possible. @gracelower, I'm not recommending a change in course yet so please proceed with your lower body housing designs.

efarq, 2025-01-31:
I think this definitely could be a good option so we can use a smaller diameter PVC in the future. I'm also pretty sure we already have those little carrier boards - I can check.

One question I have - what's the difference in the "isolated" verses "non-isolated" ?

gracelower, 2025-02-04:
Hi all,

I have an EC and RTD board here in Chapel Hill and could definitely play around with a design using those at some point. As @SUPScientist mentioned, I can stick with the i3 Interlink for now so we can get a working prototype, but I imagine it's definitely doable to use the two separate boards in the future. My only question would be how this would change our wires -- would we use two 4-wire waterproof cables? But would these then have to connect to two Borons in theory (obviously not ideal)? Or perhaps there is a way to combine the wiring from the two boards still into a single 4-wire cable and Boron. Not sure if my explanation makes any sense, but something to consider if we do end up switching from the i3 Interlink for the sake of size.

SUPScientist, 2025-02-04:
Yes, splicing the wires ought to work, so no need for additional wires.

Please put this thread on the backburner and proceed with what you have been working on (i3 interlink/tentacle shield version) to maintain momentum there.

Thread 41 (2025-04-21):

Code issues 4/17-18

gracelower, 2025-04-21:
Code listed under "Firmware" worked as desired at the December workday, but when testing the code at the April build days, we ran into the following issues:

- The code would run properly with the probes on each first reading, then would fail to produce any readings each cycle thereafter.
- Even with adding delays, playing around with different portions of the code, etc., the serial monitor would either show no results, or seemingly print what looked like EC readings for both RTD and EC.
- We used a test code provided under the EZO library with the EZO probes and boards, and confirmed that the electronics do in fact produce results properly, showing that there is likely a coding issue involving timing rather than a mechanical issue.

@efarq has been working on a new set of code that sounds promising! We will report back to this issue once that has been tested.

efarq, 2025-04-21:
I just finished a working version of the code in [this commit](https://github.com/COAST-Lab/c3po/commit/ea04c919f6e294358d89ed8a270595a4e8e2afe9)

Basically I just changed the structure of the whole thing so not as many things were happening in the step1 and step2 functions and neatened up the state machine structure. Also, I messed around with the delays a bit

gracelower, 2025-04-21:
Amazing, thanks so much Liz! @efarq

SUPScientist, 2025-04-21:
Agreed—thanks, @efarq. Changes look good.

Just a note that I still rely heavily on `Serial.print()` statements, too, but I see you changed to those from some `Log.info()` and Particle advised us to switch to `Log.info()`. Not an issue for now, but let's keep this in the back of our minds.

efarq, 2025-04-21:
That's good to know! Out of curiosity, why did they say that log.info() is better? I'll update it sometime soon

SUPScientist, 2025-04-21:
Unfortunately a rationale wasn't provided (see more [here](https://community.particle.io/t/jsn-sr04-callback-confusion/65888/2?u=supscientist)) but the person who wrote that is a top, highly reliable Particle member, so I trust the comment.

gracelower, 2025-04-22:
I remember working with the transition from `Serial.print()` to `Log.info()` this past summer with the Open Water Level Sensor so I can take a look and possibly make suggestions based on [this](https://github.com/COAST-Lab/Open-Water-Level/pull/45) and [this](https://github.com/COAST-Lab/Open-Water-Level/issues/33)

Definitely won't make any changes to your code @efarq since it's functional but I can make a separate draft using `Log.info()` that we can test sometime soon!

Closed 2025-04-21.

Thread 42 (2025-04-23):

C3PO Calibration

efarq, 2025-04-23:
Just creating an issue here to document the process I'm using to do a quick calibration for the C3PO.

Some things to note:
- The output of the conductivity is not temperature compensated. We will need to correct for temperature later in post-processing using the temperature from the RTD probe
- Eventually, we will want to make a ReadME for standard calibration practices
- In the future, to calculate salinity from conductivity, we should use the TEOS-10 equations
- The 3 standards being used for this calibration are milliQ water (reverse osmosis-ed water aka 0 uS/cm), 12880 uS/cm and 80000 uS/cm from Atlas conductivity solution, where these standards are +- 5 at 25 degrees C.

Steps I took:
1. Changed the C3PO sampling rate to every 20 seconds
2. Put the standards in individual glass beakers
3. Placed the C3PO in each beaker for 5 minutes each (to have at least a total of 10 measurements per standard), rinsing the probes with milliQ water and dabbing dry between each beaker with a Kimwipe.
4. Offload the csv file and uploaded to the Calibration folder on this Github page

Other notes:
- Plugged the C3PO in at 12:32:22 pm
- Placed C3PO into 0 uS/cm water at 12:34:40 pm
- Placed C3PO into 12,880 uS/cm solution at 12:41:53 pm but then took out to add more solution and put back in at 12:43:02 pm
- Placed C3PO into 80,000 uS/cm solution at 12:51:31 pm

SUPScientist, 2025-05-06:
I'm going to be a bit of a pain and suggest that we reopen this issue, copy and paste the notes above into a readme.md or cal_notes.md file in the Calibrations subdirectory, and then close it with a reference to that commit. If that has already been done and I'm missing it, please point to the appropriate commit in a closing message here.

SUPScientist, 2025-05-08:
@gracelower, re:

> now deleted for purposes of condensing into one issue

Truly deleted or just closed? Generally best to close but avoid deleting issues unless they're completely identical because closing them retains any discussion therein and references back and forth. Also, while the titles were the same (and too vague), the intent of the issues was arguably distinct (the other focused on applying the calibration in firmware or data analysis software whereas this one had focused on the laboratory procedure.

gracelower, 2025-05-09:
Ah, I see! Thank you so much for that clarification and I will make sure not to delete any issues in the future! The issue I had deleted was the one I had created with little to no detail and had tagged Liz, not realizing she had already created one with the same name. I had reopened her issue and transferred your comment into this thread, but can absolutely go back and recreate the two distinct threads if you'd prefer!

Thread 46 (2025-05-06):

Hood for probes

gracelower, 2025-05-06:
May be worthwhile to add a hood into the bottom cap to protect the probes from rainfall, hopefully ensuring we record sea level flooding as opposed to rainwater.

SUPScientist, 2025-05-06:
I might add the minor note that, yes, we want to prevent readings from direct rainfall onto sensor but it is totally fine to record rainwater in puddles (pluvial flooding) if those floodwaters rise from the ground up to the sensor. It doesn't have to be measuring strictly seawater, as long as the water of any source is rising up from the bottom rather than just splashing onto the sensor.

Thread 48 (2025-05-06):

Rare but extended cellular disconnection

SUPScientist, 2025-05-06:
See https://github.com/COAST-Lab/Open-Water-Level/issues/68 for a better description and link to relevant Particle Community thread. In short, there is an infrequent need for the cell modem and/or SIM card to reset and this takes much longer than the 20 seconds we use in our script:

https://github.com/COAST-Lab/c3po/blob/0f21935a2cc7cf45d4cb9fe18359057ea559fd2b/Firmware/AtlasConductivity_20240724/src/AtlasConductivity_20240724.cpp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

### To-do:

Decide what timeout should be. Considerations:
- Could be as much as 11 mins to solve corner case of IMSI update or modem update; consider changing timeout to 11 minutes.
- Alternatively, it might be more beneficial to keep timeout low to avoid burning out battery looking for a cell signal, especially if cell comms go down (e.g., during storm) and we rely on internal logging for continued data collection (of course without real-time data access).
- Find out if there is a way to force cell modem/SIM to do periodic updates in predetermined intervals. E.g., have one of us flash specific firmware every, say, 6 months to ensure cell modem/SIM are up to date, then redeploy with shorter (e.g., 20 second) timeout.

Thread 49 (2025-05-22):

Create (real-time) data visualization

SUPScientist, 2025-05-22:
### Shortcoming:
We currently have a helpful Google Sheet to log real-time data but no data visualization beyond the table of numbers.

### Recommendation:
Create a python notebook operating in, e.g., google colab that reads in data from the google sheet, parses data, and plots a conductivity (and other parameters) time-series.

Colab isn't strictly necessary but could be helpful in that the google colab/google sheets connection and online execution might facilitate quick running of the colab script to update graphs when desired.

Thread 50 (2025-05-22):

Configure correct security settings for Sheet

SUPScientist, 2025-05-22:
### Challenge
Current google sheet may have too open of permissions. I'm admittedly unsure. @efarq created the Sheet, I believe, and would likely have control over permissions.

### Recommendation
Configure sheet to not allow any arbitrary person to edit it. Allow permissions for small core team (@efarq, @gracelower, @SUPScientist, @BentleySettin would likely suffice) as well as Particle Cloud (which needs special read/write access for the integration).

It's possible that it already has correct or best available permissions, but it is critical that we confirm this.

gracelower, 2025-05-22:
Excellent note. On my end, it appears that the spreadsheet was "editable" by anyone on the internet (as pictured below). This can easily be fixed by adjusting the sharing settings to "Restricted," which allows only people added to the sheet (i.e. individuals added to the NASA Google Folder / Conductivity folder). I can do this, or I can let @efarq handle it in case adjusting the settings messes with any of the data collection (I don't think it should, but just in case).
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

SUPScientist, 2025-05-23:
> in case adjusting the settings messes with any of the data collection

My concern is that in the instructions we follow to configure the Particle/Sheets connection, it says, "Who has access --> Anyone" and I'm not sure what the ramifications of changing that might be. I suppose it should be an easy test, though maybe best done on a test Sheet first to see if/how it works rather than messing with the Sheet that is our only operational data access currently.
