COAST-Lab/c3po/(commit log)

2024-06-27 Rename Circuit-Diagram (2).png to Circuit Diagram/Initial Diagram
2024-06-28 Rename Circuit-Diagram (2).png to Wiring Diagram/Circuit-Diagram (2).png
2024-06-28 Rename Conductivity Sensor Initialization.pdf to Documentation/Conductivity Sensor Initialization.pdf
2024-06-28 Rename Conductivity Sensor Initialization (1).pdf to Documentation/Conductivity Sensor Initialization (1).pdf
2024-07-17 added photo folder for documentation and created a readme.md file for conductivity sensor initialization, instead of .pdf (For ease of use)
2024-07-17 wiring diagram from atlas sci
2024-07-24 created new project with code updated from Serial.print to Log.info formatting (new project because file pathways were wonky in AtlasCond 2)
2024-07-24 updated README.md file with more detailed instructions for initializing Atlas CS, wiring the Atlas and Boron, and using Firmware (links need fixing once pull request is approved)
2024-07-31 added details + parts to BOM, added photo
2024-07-31 formatting BOM
2024-07-31 improved BOM / added details
2024-07-31 BOM formatting
2024-08-30 Revert "publishing updates"
    This reverts commit 98569fbbfc086edc8d59a3aa129e15152d4f367c.
    [AtlasConductivity_20240724.cpp]
2024-08-30 Revert "rtd/publish changes"
    This reverts commit acf5ca1b8a59e9381c85d0e5334ffebf566b2e37.
    [AtlasConductivity_20240724.cpp]
2024-08-30 Reapply "rtd/publish changes"
    This reverts commit 0126f568782c41dbe0e3124a5bd547f7f893c80d.
    [AtlasConductivity_20240724.cpp]
2024-08-30 Revert "rtd/publish changes"
    This reverts commit 856528518192c6e5f4f782091ec78bd1b480a14d.
    [AtlasConductivity_20240724.cpp]
2024-09-27 updated BOM to include temperature sensor + new components
2024-09-30 temp probe datasheet
2024-10-01 added temp probe datasheet to hardware
2024-11-01 adding SetUp.md file with new instructions to account for two sensors, housing updates, changes to assembly, etc.
2024-11-01 added photo of updated wiring diagram to repo and instructions
2024-11-11 reorganizing BOM
2024-11-11 added tentacle t3 to bom
2024-11-11 updated BOM
2024-11-27 Create I2C_LED_Status.png
    added I2C led status photo for documentation
2024-11-27 Create WiringDiagram_20241127.jpg
    updated wiring diagram
2024-11-27 Delete WiringDiagram_20241101.jpg
    removed incorrect wiring diagram
2024-11-27 Create WiringDiagram_20241101.jpg
    moved incorrect wiring diagram to "old" photo folder
2024-12-17 Create Blink_LED.cpp
    added Blink_LED.cpp template file; adding a step of documentation for Blink LED process
2024-12-18 Update with new settings template and testing publishing/connection issues
    [AtlasConductivity_20240724.cpp]
2024-12-19 Corrected wiring diagram + updated documentation with OS changes
    Corrected wiring diagram; updated instructions to reflect new diagram photo (from Canva) and to accommodate OS issues (see: (Re)Gain Boron in c3po project)
2024-12-20 New wiring digram using Port 4 on Tentacle T3 Shield
    New wiring digram using Port 4 on Tentacle T3 Shield; placed incorrect versions of wiring diagram in "Old" folder (under documentation)
2024-12-20 Embedded new wiring diagram photo into Set-Up instructions
2025-01-14 Copied new Wiring Diagram to wiring diagram folder
2025-01-14 Update .cpp code for sensor
    added delays after commands to make sure sensor had time to complete each step for producing results to serial monitor
2025-01-15 Updated BOM
    updated BOM to match current state of designs (working on prototype with polycase knockouts, cable glands, etc.)
2025-01-23 Updated BOM
    Separated BOM based on upper & lower bodies, adding additional materials like screws, hex nuts, cable glands, etc.
2025-01-23 Updated BOM
    Updated "parts in progress"
2025-01-24 Updated BOM
    added screws + hex nuts to upper body chassis
2025-01-24 Updated BOM
    updated BOM to reflect new chassis designs
2025-01-24 Updated BOM
    updated BOM to reflect new chassis / parts
2025-03-28 updated BOM + cable gland datasheets
2025-03-28 Added .stl files for 3D drafts
    March 28 2025
    [BottomCap_20250328.stl, TopCap_20250328.stl, UpperBody_Chassis_20250328.stl]
2025-04-02 Updated set-up / assembly instructions
2025-04-09 .stl files ready to print!
    Polycase internal chassis + top and bottom caps for PVC pipe
    [BottomCap_20250408.stl, TopCap_20250408.stl, UpperChassis_20250408.stl]
2025-04-09 moved outdated 3D files to "Old" folder
    [BottomCap_20250328.stl, TopCap_20250328.stl, UpperBody_Chassis_20250328.stl]
2025-04-23 Adding Calibration files
    [conductivity.csv]
2025-05-06 add sheets data through today, downloaded as .csv
    [TinyCamMLConductivity - Sheet1 - 20250506.csv]
2025-05-08 Swapped .stl files for Top & Bottom Caps
    Moved .stl files from Apr 4 to "Old" in Hardware; added .stl files from May 8. These designs are thinner, shorter, and do not include grooves for O-rings.
    [BottomCap_20250408.stl, BottomCap_NoGrooves_20250508.stl, TopCap_20250408.stl, TopCap_NoGrooves_20250508.stl]
2025-06-23 Adding some initial plotting code
    [CO-OPS__8658163__wl.csv, MayandJuneRainData.csv]
2025-06-25 Added V1 of improved solar panel mount
    [C3POPolycaseMountpart.stl, solar_panel_mount_v4.stl]
2025-07-16 applying calibration and converting to PSS
    Worked on creating a linear regression for the C3PO calibration data to create a calibration curve that can be applied to future data. Also created a R Studio file to use for converting conductivity values to salinity PSS
    [2025_07_02_C3PO_Offload.csv, CB02JuneJuly.csv, ConductivitywithSalinity.csv, JuneJulyRain.csv, conductivity.csv, merged.csv, step_pts_interp.csv]
2025-10-13 add latest gsheets data and simple time-series plotter
    [2025_04_24_to_2025_10_13_PublishedData.csv]
2025-11-11 Added battery voltage monitoring
2025-11-11 Add file from C3PO Offload
    [2025_07_10_to_2025_08_13_C3POOffload.csv]
2025-12-02 Added salinity data to recent plots
    [ApriltoOctoberSalinity.csv, CB02ApriltoOctober.csv]
2026-04-20 Create ReadMe.md for Removable Housing project
    Added detailed objectives, design improvements, benefits, and notes for the removable housing project.
2026-04-20 Add files via upload
    Original 3D printing file for a cap with no holes for screws or sensors
    [Robust_Cap_NoHoles.f3d]
2026-04-20 Add files via upload
    3D print files - Added screw holes for exterior fastening
    [Robust_Cap_ScrewHoles.f3d]
2026-04-20 Add files via upload
    STL File used for printing, includes: End cap with screw holes, o-ring grooves, chamfer
    [C3PO_RobustCap_04132026.stl]
2026-04-20 Add dimensions and specifications for housing components
    Added detailed specifications for exterior PVC pipe, end cap, O-ring, and sensor ports.
2026-04-23 Concept Diagram
    Conceptual Drawing of housing changes: Removable Caps with ports (power, connection to brain, 3 sensors), O-ring seals on the inside of caps, Exterior fastening screws
2026-04-29 Revise ReadMe for Removable Housing project
    Updated formatting and added details about design improvements and benefits.
2026-06-15 add exo2s data from validation work
    [Kor Measurement File Export - 061526 180140_2026-06-14_2100_C3PO.csv, Kor Measurement File Export - 061526 180532_2026-06-14_2000_C3PO.csv]
2026-07-22 adding recalibration data
    [conductivity.csv]
2026-07-30 adding intercomparison experiment data
    [2026_07_30_C3PO2.csv, 2026_07_30_C3PO3.csv, 2026_07_30_C3PO4.csv, 2026_07_30_C3PO5.csv, 2026_07_30_C3PO6.csv, Kor Measurement File Export - 073026 134433_C3POIntercomparisonExperiment.csv, merged.csv]
